wuyang20061105-oss/roboarm-_yang/Design_Notes.txt

RA-P300 精密机械臂概念迭代 | 2026-10-31 | 单位 mm
参考 RobotArm / BCN3D Moveo 模板拓扑重建；原 SLDASM 未直接导入。
4DOF + 平行夹爪，当前为静态装配；95 个原生三维实体，按部件分层。
中心距：上臂 125，前臂 100，腕心至指尖 75；名义中心线伸展 300。
底板 150x130x12；4x直径8.6通孔，直径14沉孔深6；中心走线孔直径22。
肩/肘/腕轴直径 16/14/12；上臂板厚8，前臂板厚7；夹爪开口32。
含减重窗、横撑、轴承座、法兰、内六角螺栓、散热环、夹垫及柔性线束。
电机、减速器、轴承及丝杆为外形示意；未建内部传动、装配运动约束。
未验证制造公差、负载刚度、驱动扭矩、重复定位精度及全行程干涉。
DWG 含 01_ISOMETRIC / 02_FRONT / 03_TOP / 04_SIDE 命名视图；审计错误0。
SAT 为实体交换文件；PNG 为 AutoCAD 原生导出预览。
