wuyang20061105-oss/roboarm-_yang/RA_P300_Preview.png

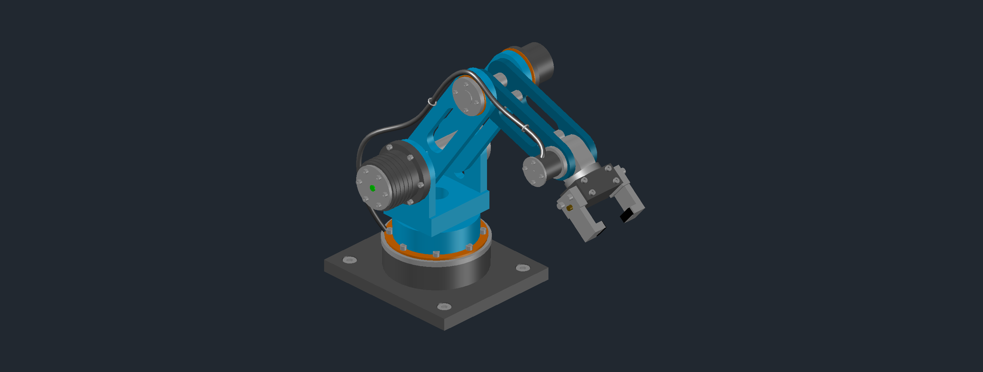
RA_P300_Preview.png
