wuyang20061105-oss/roboarm-_yang/CAD files/Driver.SLDASM

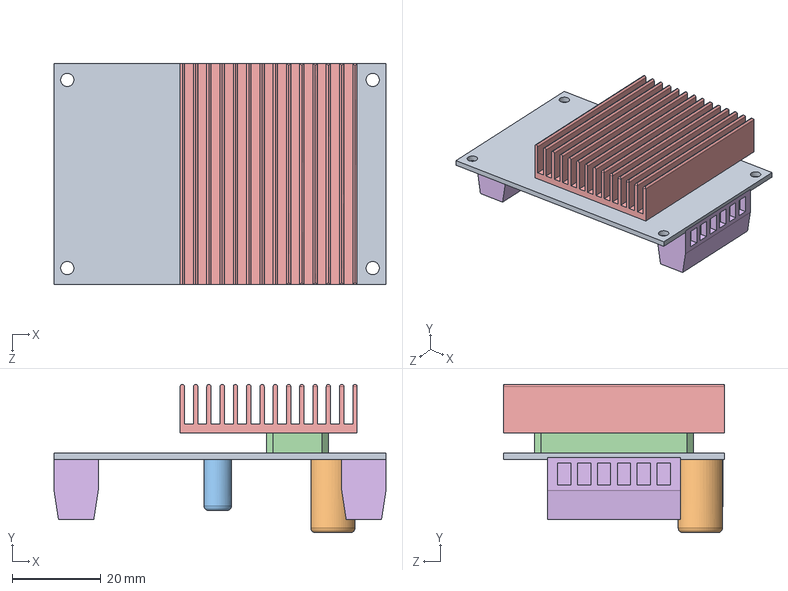
[picture p2: CAD file, 2026-10-31]
CAD files/Driver.SLDASM
75.0 x 33.5 x 50.0 mm
PCB TB6560
Capacitor 1
Capacitor 2
Chip
Sink
Terminal x 2
