wuyang20061105-oss/roboarm-_yang/CAD files/M1 Tensor D.SLDASM

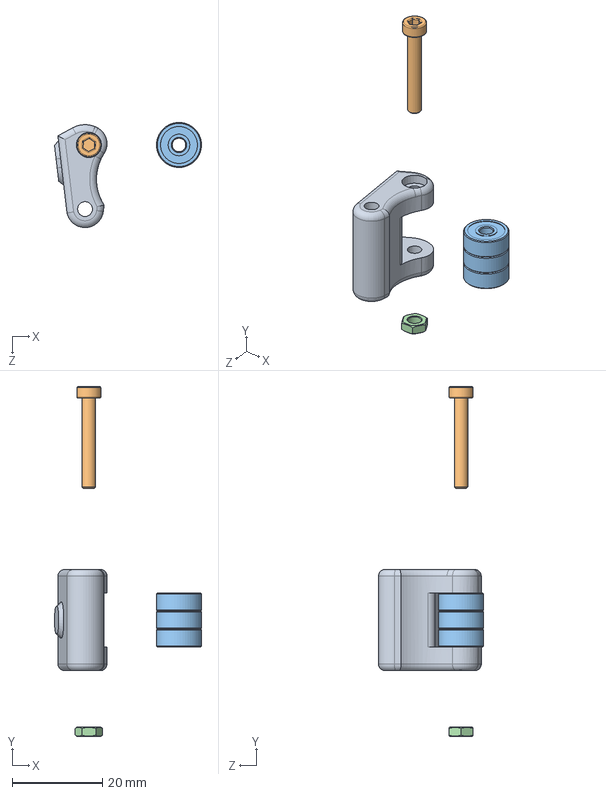
[picture p3: CAD file, 2026-10-31]
CAD files/M1 Tensor D.SLDASM
32.6 x 77.7 x 23.3 mm
T4M1E
M3x20
Bearing 3Bore 10Ext 4Height x 3
M3 Nut
