wuyang20061105-oss/roboarm-_yang/RobotArm.SLDASM

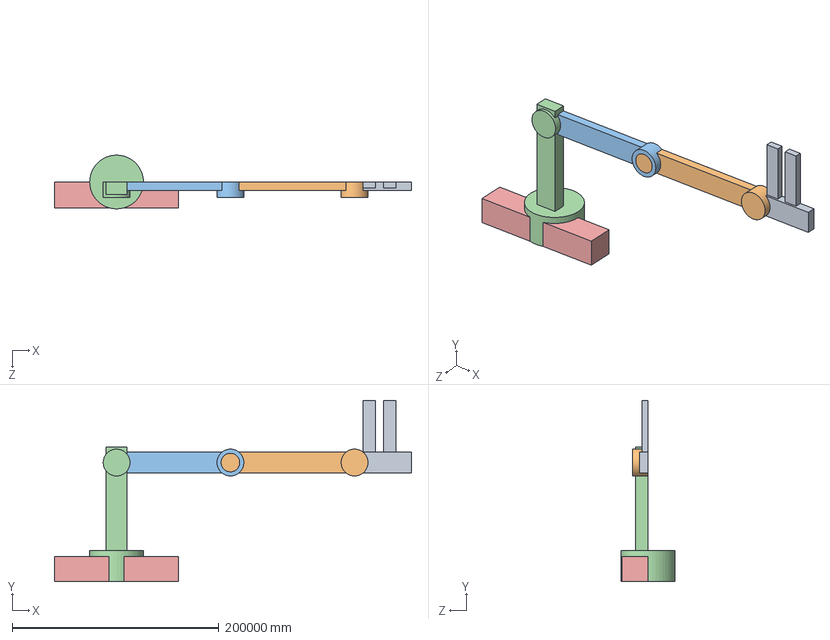
[picture p4: CAD file, 2026-10-31]
RobotArm.SLDASM
345000.0 x 175000.0 x 52000.0 mm
RobotArm_Base
RobotArm_Tower
RobotArm_UpperArm
RobotArm_Forearm
RobotArm_Hand
