wuyang20061105-oss/roboarm-_yang/CAD files/3M2.SLDASM

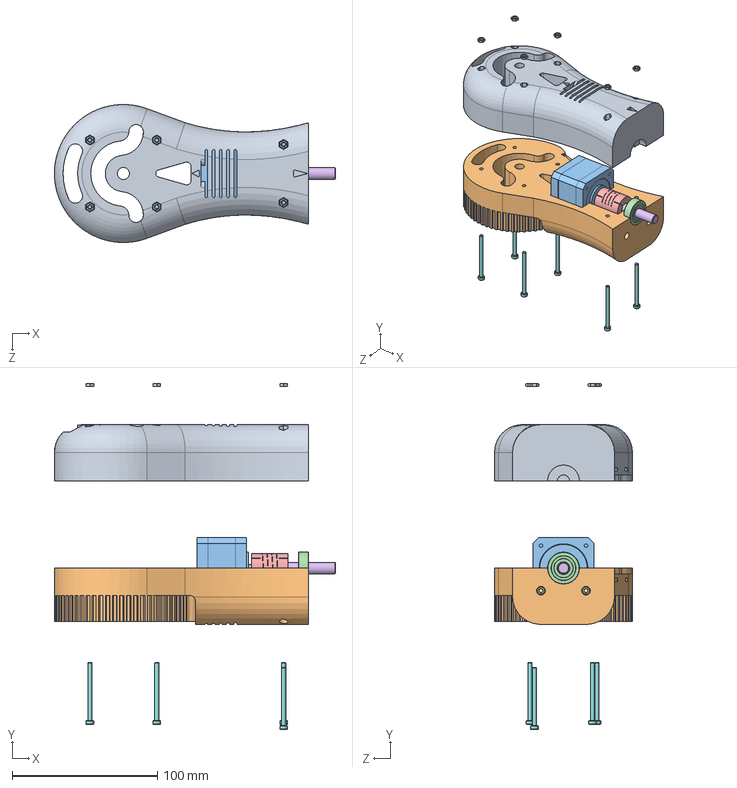
[picture p7: CAD file, 2026-10-31]
CAD files/3M2.SLDASM
193.6 x 238.2 x 95.0 mm
3M2C
3M2CC
Nema 17 Curt
8mm Bearing
Coupling 5 to 8 mm
Smooth bar 8mm x 50mm
M3x10 x 2
M3x40 x 6
M3 Nut x 6
