wuyang20061105-oss/roboarm-_yang/CAD files/BCN3D Moveo assembly.SLDASM

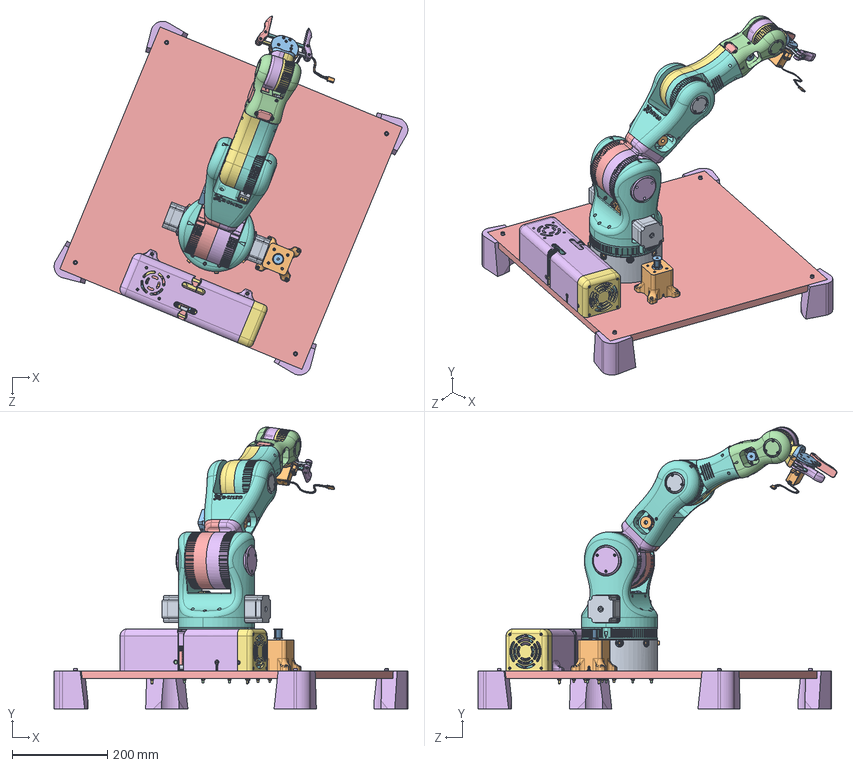
[picture p8: CAD file, 2026-10-31]
CAD files/BCN3D Moveo assembly.SLDASM
742.4 x 591.8 x 753.4 mm
1M2A
M5x20 x 8
Bearing 5mm x 8
Spacer M5x10 x 8
Spacer M8x20 x 2
8mm Bearing x 10
M5 Lock x 20
2M1D
Nema 23 x 2
M5x15 x 8
T2M1BI
M3 Nut x 27
M4 Nut x 7
M4x20 x 3
Bearing 4Bore 13Ext 5 x 9
T2M1BD
Arandela
Pulley 8mm IGNIS x 3
Smooth bar 8mm x 140mm
Brass insert M4 x 3
1M1B
M4x45 x 6
M4 Locknut x 20
M8x65
M8 Autoblocant x 2
2M2HA
2M2MA
M4x30 x 10
3M1D
T3M1C
M3x40 x 7
Nema 17 Reductor
M3x12 x 12
M4x16 x 4
Brass insert M3 x 14
Smooth bar 8mm x 121mm
3M2C
3M2CC
Nema 17 Curt
Coupling 5 to 8 mm
Smooth bar 8mm x 50mm
M3x10 x 16
4M1D
Nema 14
M3x8 x 5
T4M1E
M3x20
Bearing 3Bore 10Ext 4Height x 3
M3x35 x 5
Pulley M5 x 2
Tapa 4M1D x 2
TBC
4M2B
4M2CB
M3x25 x 3
Barra llisa 8mm x 80mm
Bottom Plate C
Top Plate C
Cilinder x 2
Gripper Left B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
