wuyang20061105-oss/roboarm-_yang/CAD files/2.SLDASM

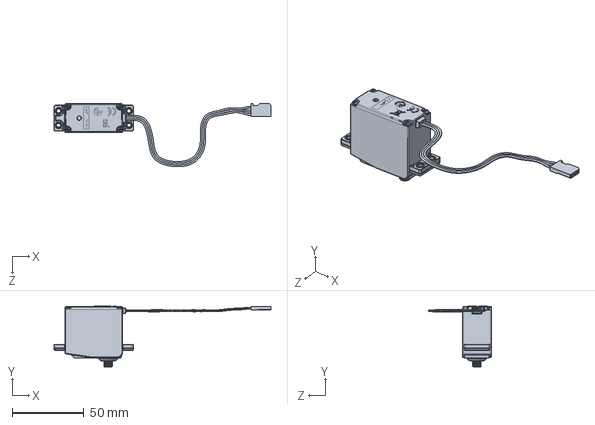
[picture p9: CAD file, 2026-10-31]
CAD files/2.SLDASM
151.2 x 42.3 x 44.1 mm
