wuyang20061105-oss/roboarm-_yang/CAD files/4M2.SLDASM

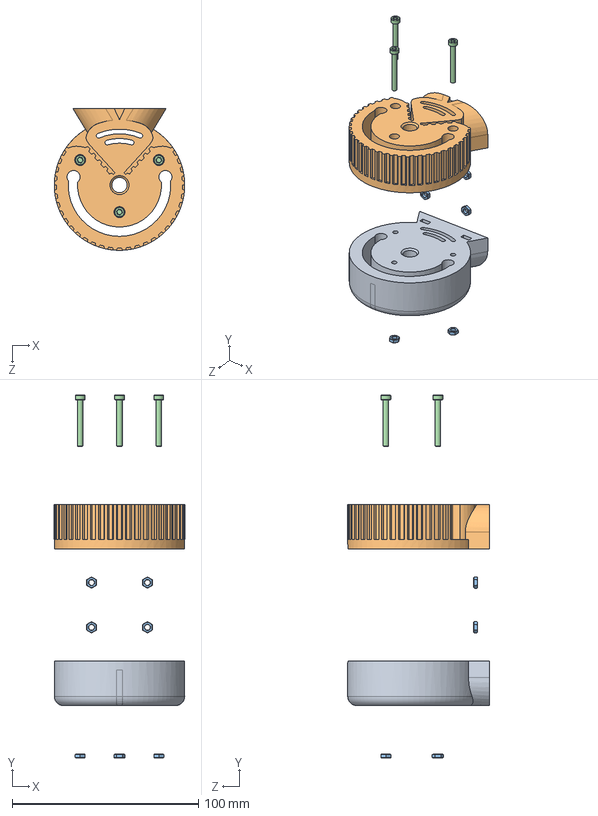
[picture p11: CAD file, 2026-10-31]
CAD files/4M2.SLDASM
70.0 x 194.7 x 76.0 mm
4M2B
4M2CB
M3 Nut x 7
M3x25 x 3
