wuyang20061105-oss/roboarm-_yang/CAD files/Drivers Support Assembly B.SLDASM

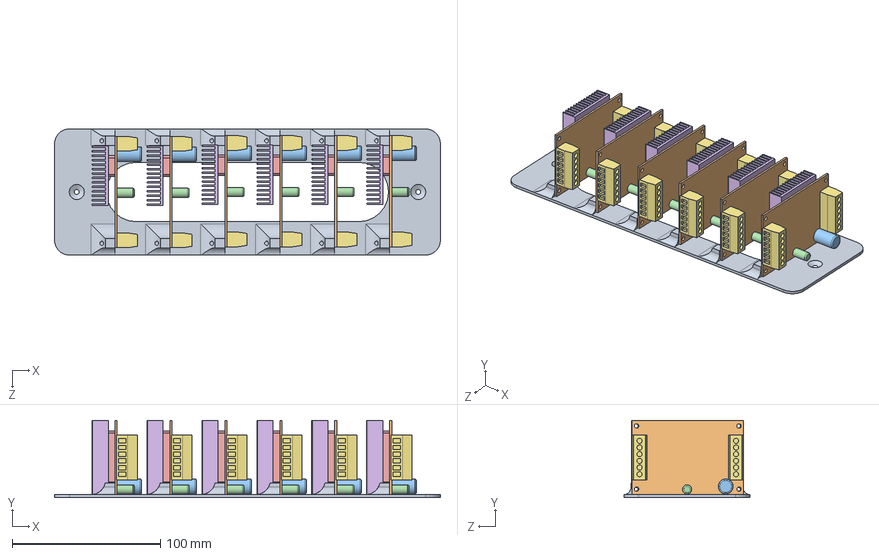
[picture p13: CAD file, 2026-10-31]
CAD files/Drivers Support Assembly B.SLDASM
260.0 x 52.0 x 85.0 mm
Suport Drivers E
PCB TB6560 x 6
Capacitor 1 x 6
Capacitor 2 x 6
Chip x 6
Sink x 6
Terminal x 12
