wuyang20061105-oss/roboarm-_yang/CAD files/Gripper B Assembly.SLDASM

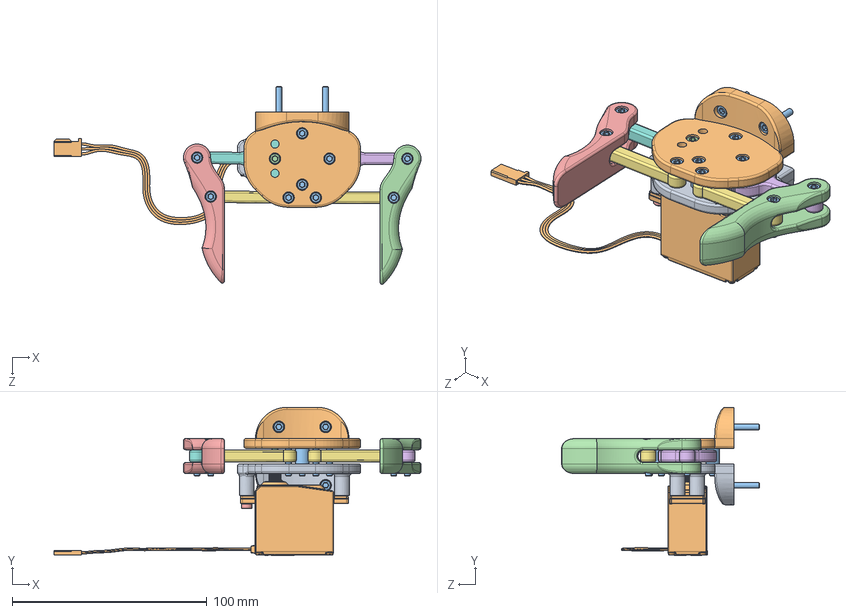
[picture p15: CAD file, 2026-10-31]
CAD files/Gripper B Assembly.SLDASM
188.5 x 76.1 x 101.5 mm
Bottom Plate C
Top Plate C
Cilinder x 2
Gripper Left B
Gripper Right B
Idol Gear B
Pivot Arm B x 2
Servo Gear B
M3 Nut x 9
Servo Futaba S3003
M3x16 x 13
M3x8
