wuyang20061105-oss/roboarm-_yang/CAD files/1M3.SLDASM

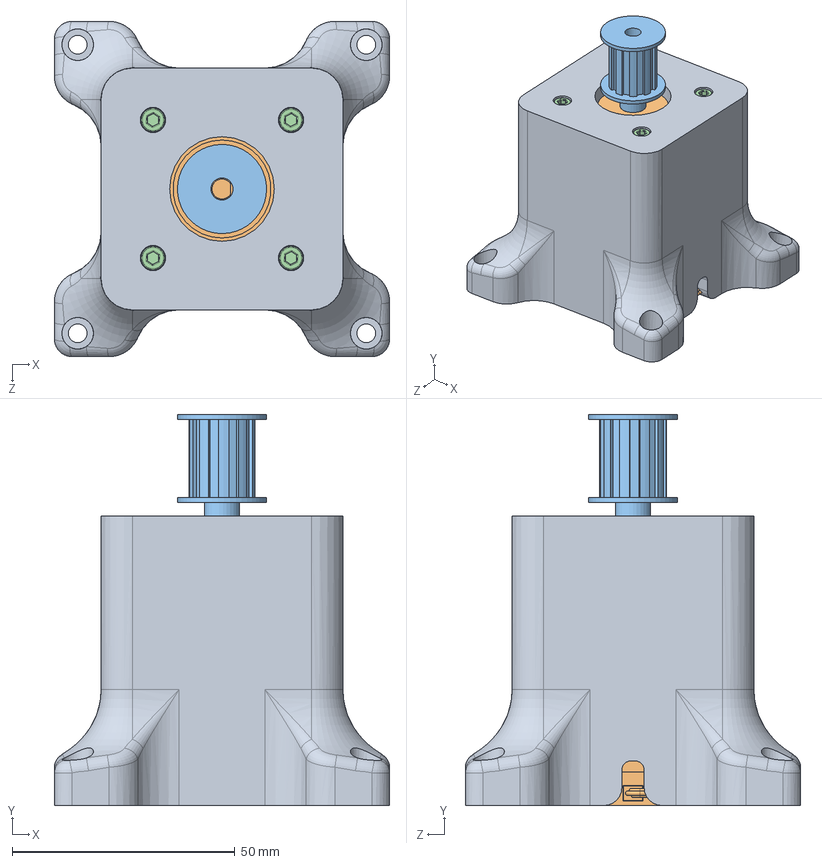
[picture p16: CAD file, 2026-10-31]
CAD files/1M3.SLDASM
75.3 x 87.8 x 75.3 mm
1M3A
Nema 17 Llarg
Pulley M5
M3x10 x 4
