wuyang20061105-oss/roboarm-_yang/CAD files/4M.SLDASM

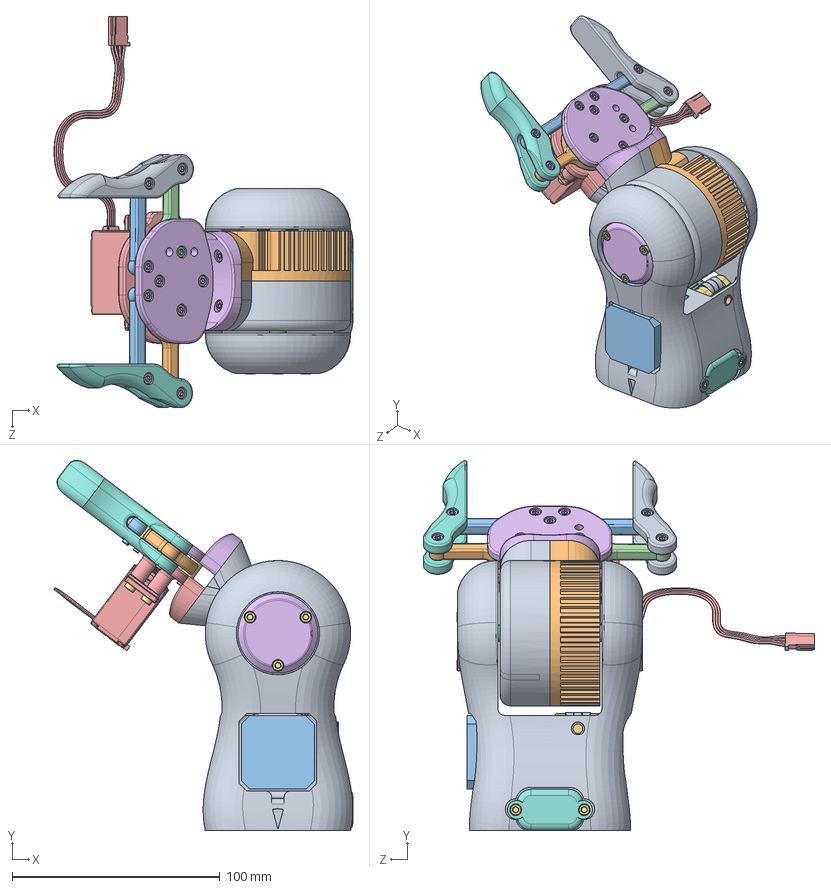
[picture p17: CAD file, 2026-10-31]
CAD files/4M.SLDASM
144.0 x 178.2 x 188.5 mm
4M1D
M3 Nut x 18
Nema 14
M3x8 x 5
8mm Bearing x 3
M8 Autoblocant
T4M1E
M3x20
Bearing 3Bore 10Ext 4Height x 3
M3x35
Pulley M5
Brass insert M3 x 8
Brass insert M4
Tapa 4M1D x 2
M3x12 x 8
TBC
4M2B
4M2CB
M3x25 x 3
Barra llisa 8mm x 80mm
Bottom Plate C
Top Plate C
Cilinder x 2
Gripper Left B
Gripper Right B
Idol Gear B
Pivot Arm B x 2
Servo Gear B
Servo Futaba S3003 x 2
M3x16 x 13
M3x10 x 4
