wuyang20061105-oss/roboarm-_yang/CAD files/2M2M assembly.SLDASM

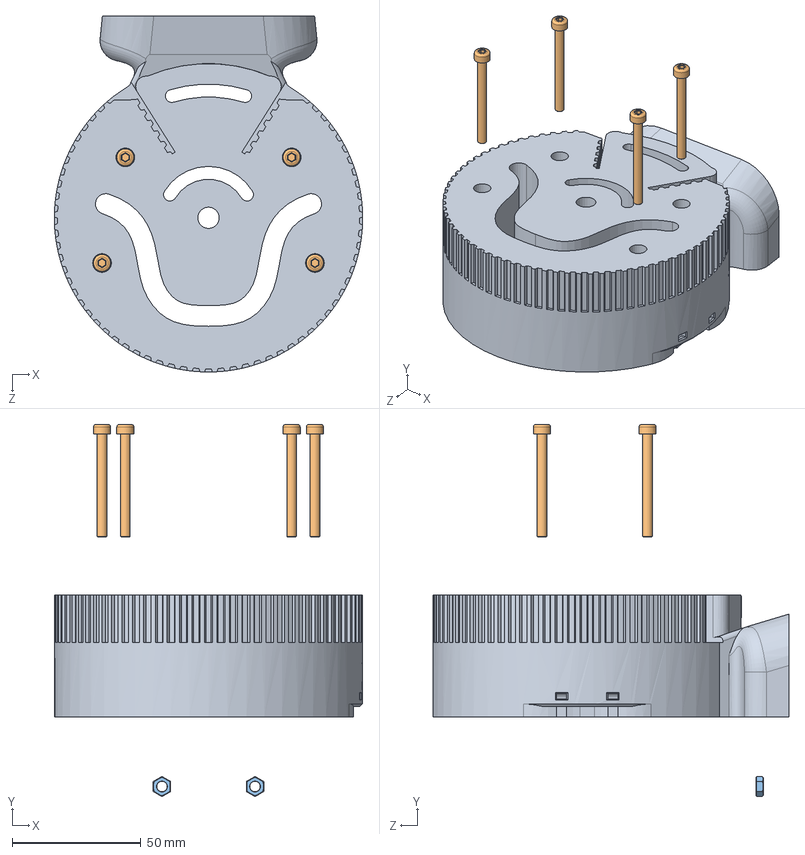
[picture p18: CAD file, 2026-10-31]
CAD files/2M2M assembly.SLDASM
120.0 x 144.8 x 138.5 mm
2M2MA
M4x40 x 4
M4 Nut x 2
