wuyang20061105-oss/roboarm-_yang/CAD files/1M2A.SLDPRT

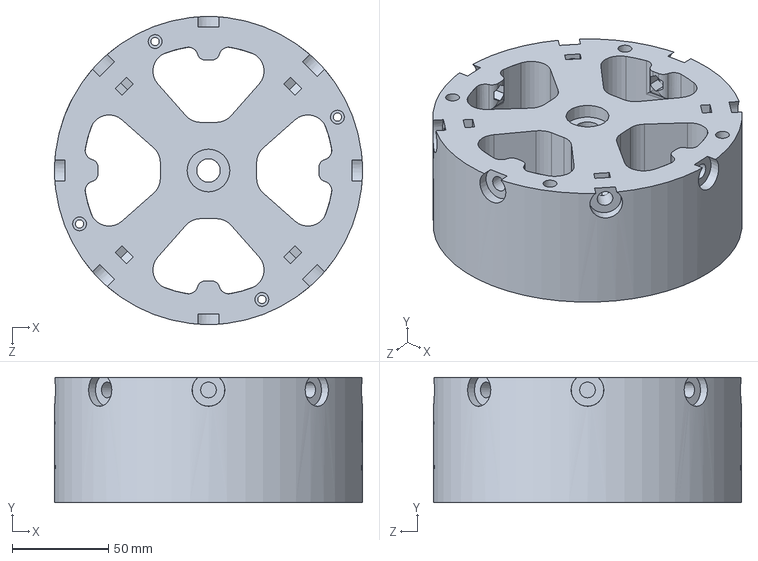
[picture p19: CAD file, 2026-10-31]
CAD files/1M2A.SLDPRT
160.0 x 65.0 x 160.0 mm
