wuyang20061105-oss/roboarm-_yang/RobotArm_Tower.SLDPRT

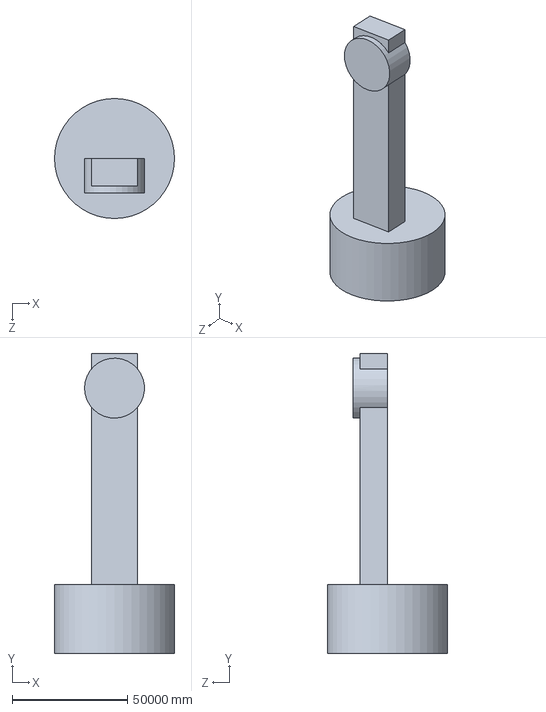
[picture p20: CAD file, 2026-10-31]
RobotArm_Tower.SLDPRT
52000.0 x 130000.0 x 52000.0 mm
