wuyang20061105-oss/roboarm-_yang/STL files/Articulation 1/1M1.STL

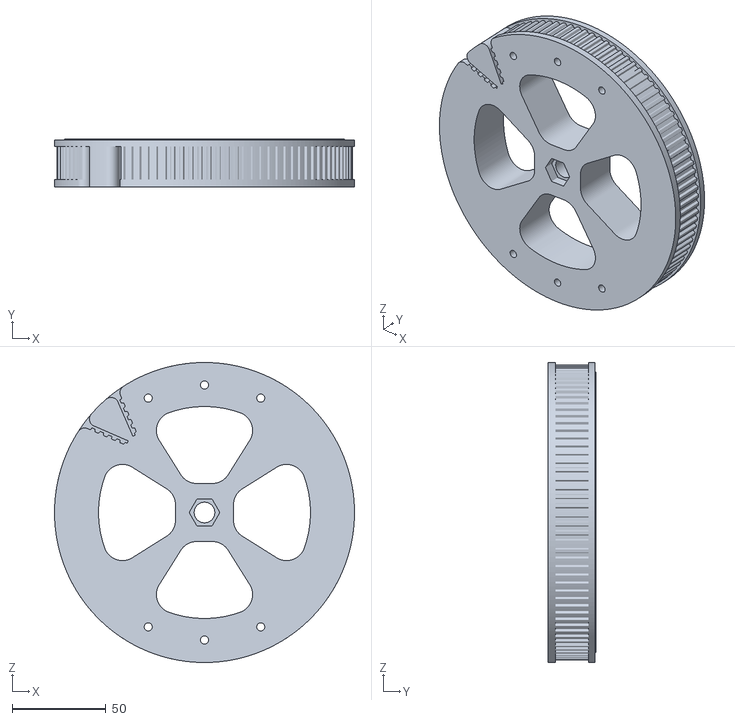
[picture p21: CAD file, 2026-10-31]
STL files/Articulation 1/1M1.STL
160.0 x 25.5 x 160.0
