wuyang20061105-oss/roboarm-_yang/STL files/Articulation 2/2M2M.STL

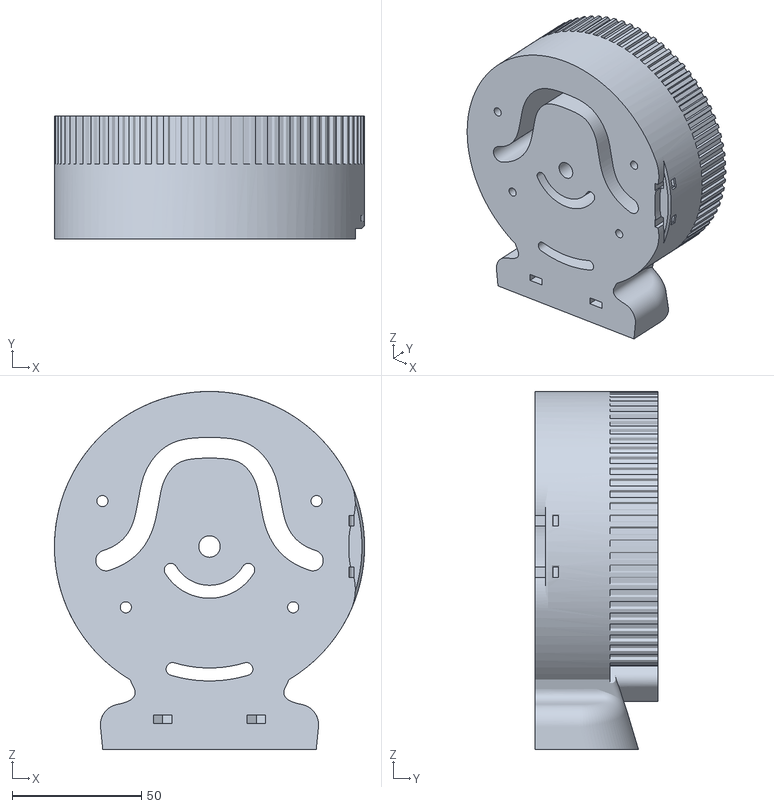
[picture p22: CAD file, 2026-10-31]
STL files/Articulation 2/2M2M.STL
120.0 x 47.5 x 138.5
