wuyang20061105-oss/roboarm-_yang/STL files/Articulation 3/T3M1C.stl

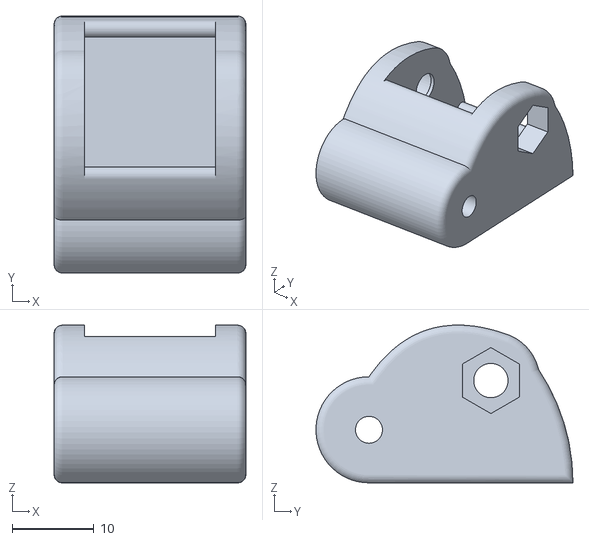
[picture p23: CAD file, 2026-10-31]
STL files/Articulation 3/T3M1C.stl
23.5 x 31.5 x 19.3
