wuyang20061105-oss/roboarm-_yang/STL files/Base/Potes.STL

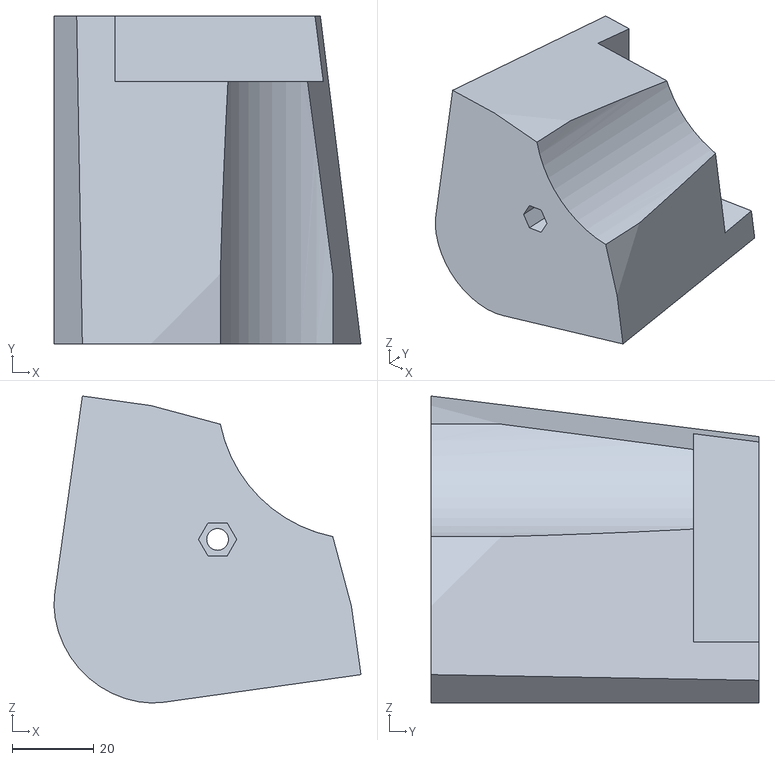
[picture p25: CAD file, 2026-10-31]
STL files/Base/Potes.STL
74.9 x 80.0 x 74.9
