wuyang20061105-oss/roboarm-_yang/STL files/Cover/Tapa 3M1.STL

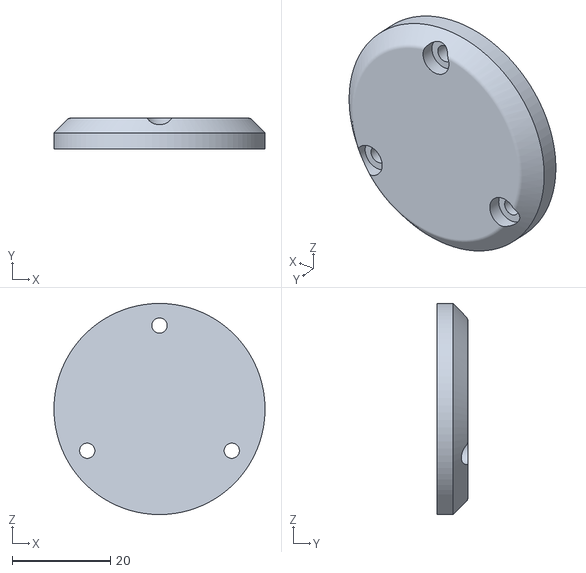
[picture p26: CAD file, 2026-10-31]
STL files/Cover/Tapa 3M1.STL
43.0 x 6.30 x 43.0
