wuyang20061105-oss/roboarm-_yang/STL files/Electronics box/Box.STL

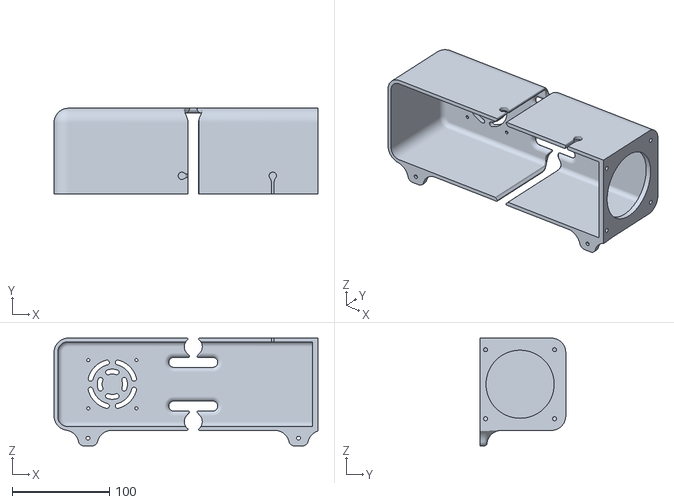
[picture p27: CAD file, 2026-10-31]
STL files/Electronics box/Box.STL
271.5 x 88.0 x 111.0
