wuyang20061105-oss/roboarm-_yang/STL files/Machine - tool/Top Plate.STL

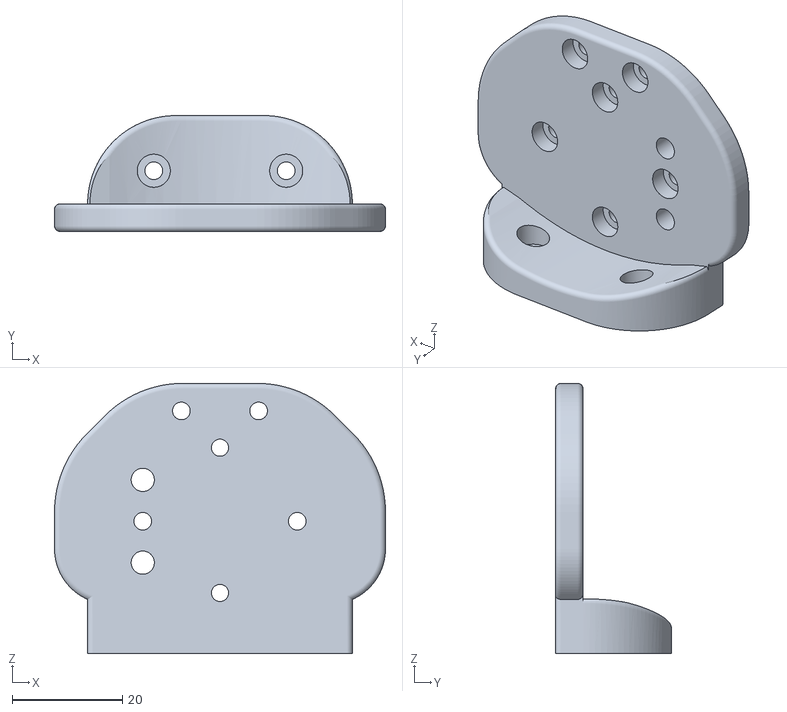
[picture p28: CAD file, 2026-10-31]
STL files/Machine - tool/Top Plate.STL
60.0 x 21.0 x 49.0
