wuyang20061105-oss/roboarm-_yang/CAD files/Bearing 5mm.SLDPRT

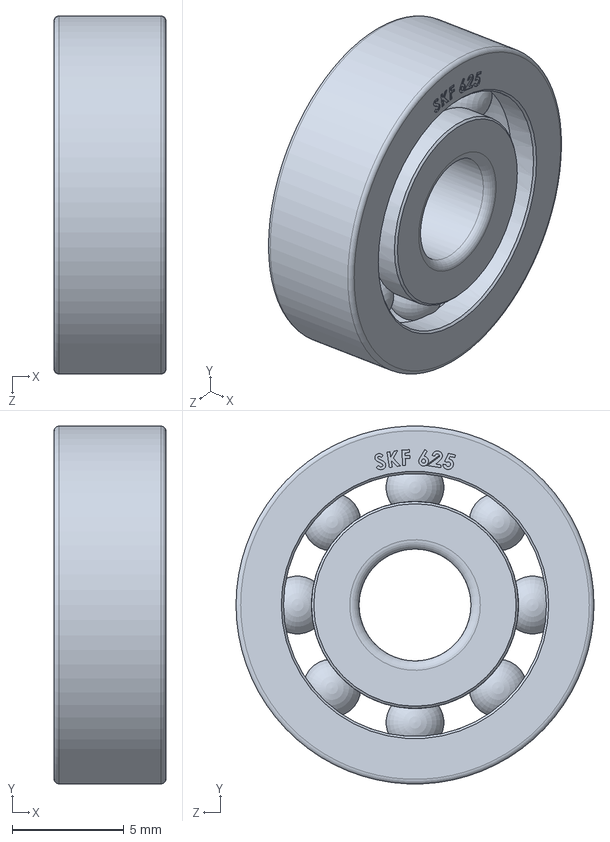
[picture p29: CAD file, 2026-10-31]
CAD files/Bearing 5mm.SLDPRT
5.00 x 16.0 x 16.0 mm
