wuyang20061105-oss/roboarm-_yang/RobotArm_Base.SLDPRT

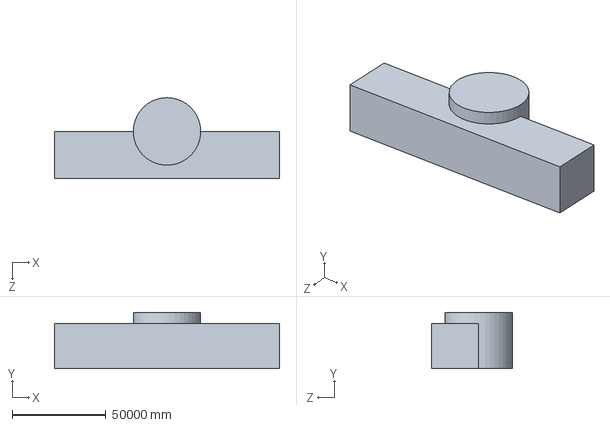
[picture p30: CAD file, 2026-10-31]
RobotArm_Base.SLDPRT
120000.0 x 30000.0 x 43000.0 mm
