wuyang20061105-oss/roboarm-_yang/STL files/Articulation 3/3M2C.STL

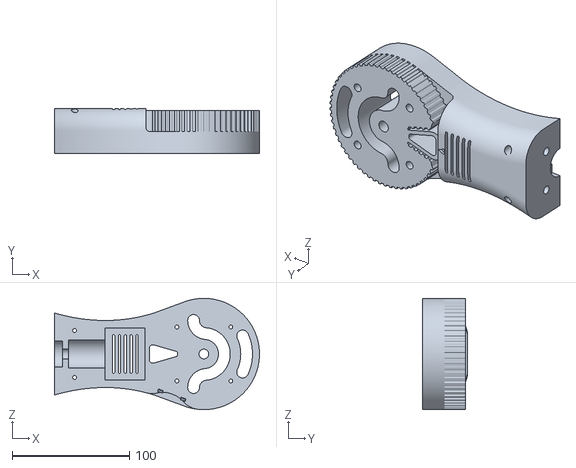
[picture p31: CAD file, 2026-10-31]
STL files/Articulation 3/3M2C.STL
175.0 x 38.8 x 95.0
