wuyang20061105-oss/roboarm-_yang/STL files/Articulation 4/4M1.STL

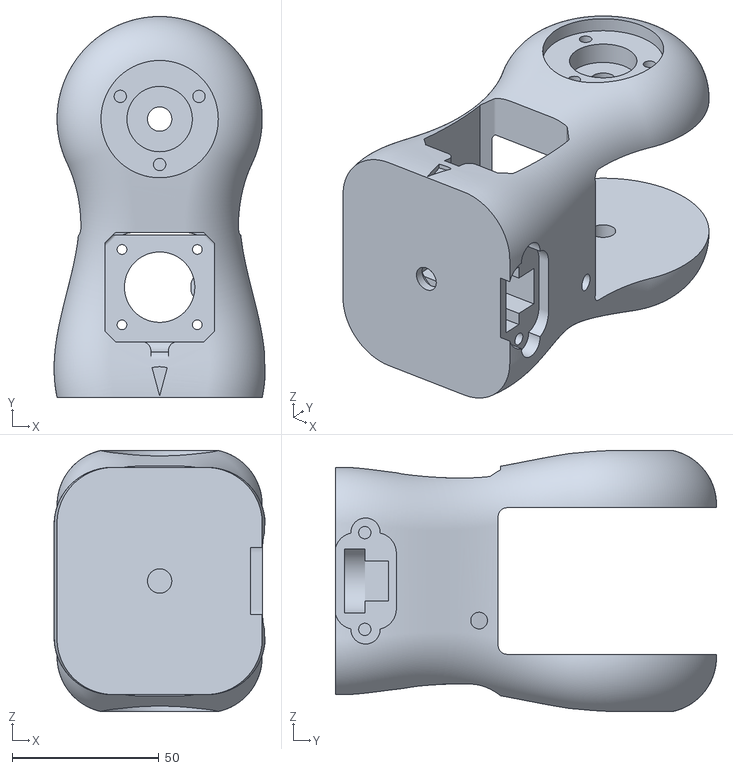
[picture p32: CAD file, 2026-10-31]
STL files/Articulation 4/4M1.STL
71.9 x 130.0 x 89.1
