wuyang20061105-oss/roboarm-_yang/STL files/Cover/Tapa 2M1.STL

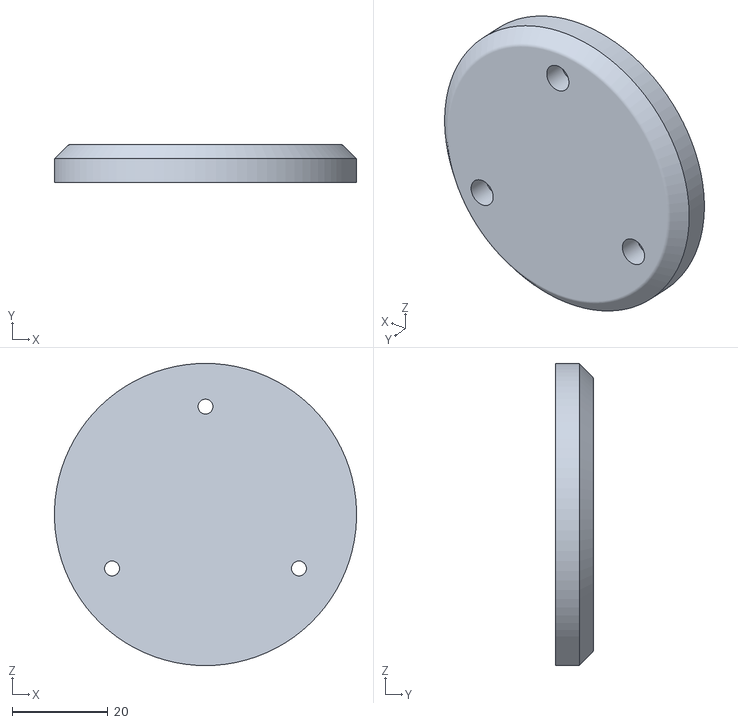
[picture p33: CAD file, 2026-10-31]
STL files/Cover/Tapa 2M1.STL
63.0 x 8.00 x 63.0
