wuyang20061105-oss/roboarm-_yang/STL files/Electronics box/Fan Module.STL

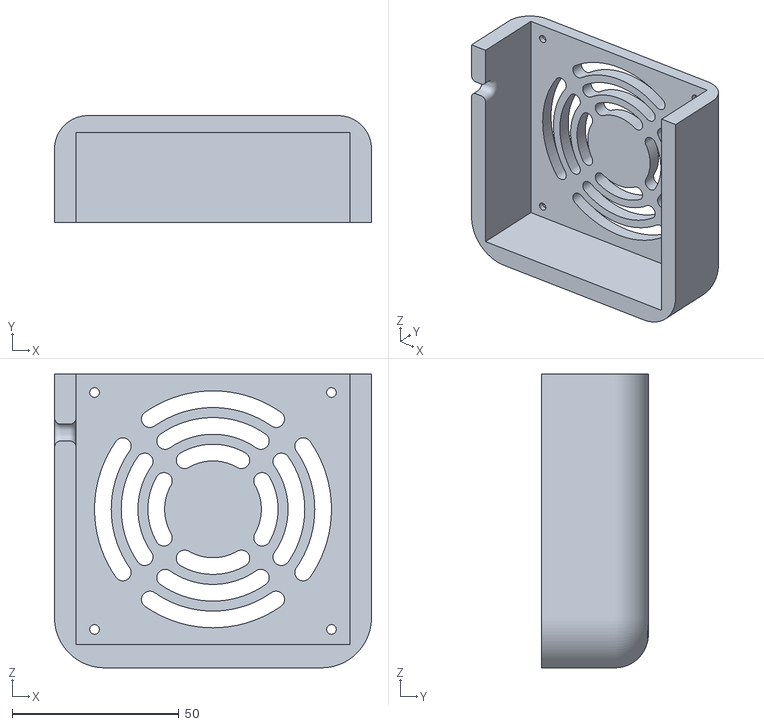
[picture p34: CAD file, 2026-10-31]
STL files/Electronics box/Fan Module.STL
95.0 x 32.0 x 88.0
