wuyang20061105-oss/roboarm-_yang/STL files/Machine - tool/Gripper Left.STL

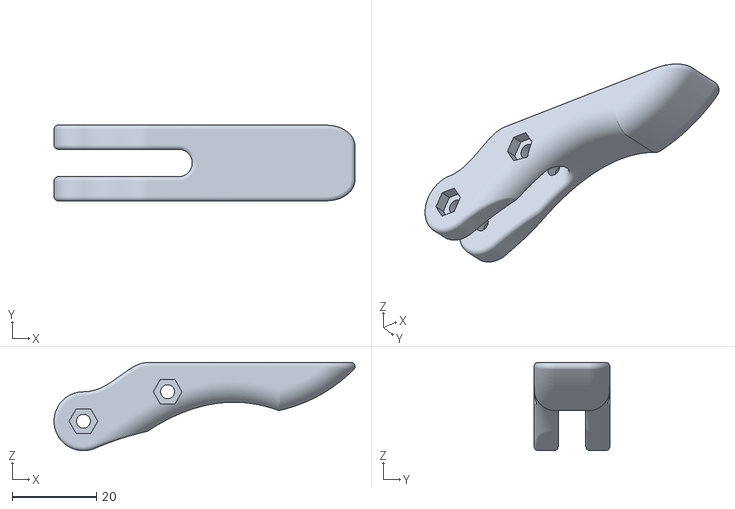
[picture p35: CAD file, 2026-10-31]
STL files/Machine - tool/Gripper Left.STL
71.5 x 18.0 x 21.0
