wuyang20061105-oss/roboarm-_yang/CAD files/Arandela.SLDPRT

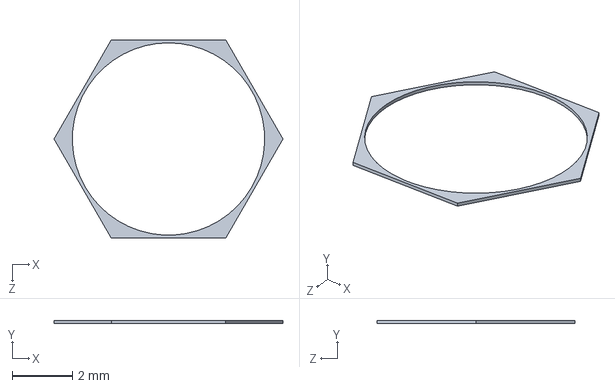
[picture p36: CAD file, 2026-10-31]
CAD files/Arandela.SLDPRT
7.62 x 0.1 x 6.60 mm
