wuyang20061105-oss/roboarm-_yang/RobotArm_Hand.SLDPRT

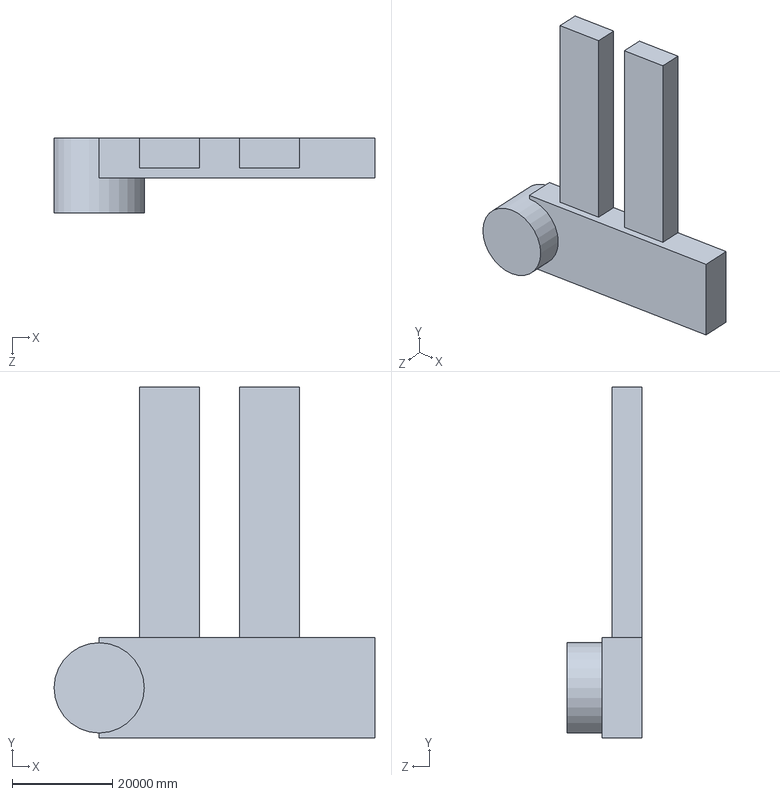
[picture p37: CAD file, 2026-10-31]
RobotArm_Hand.SLDPRT
64000.0 x 70000.0 x 15000.0 mm
