wuyang20061105-oss/roboarm-_yang/STL files/Articulation 1/1M3.STL

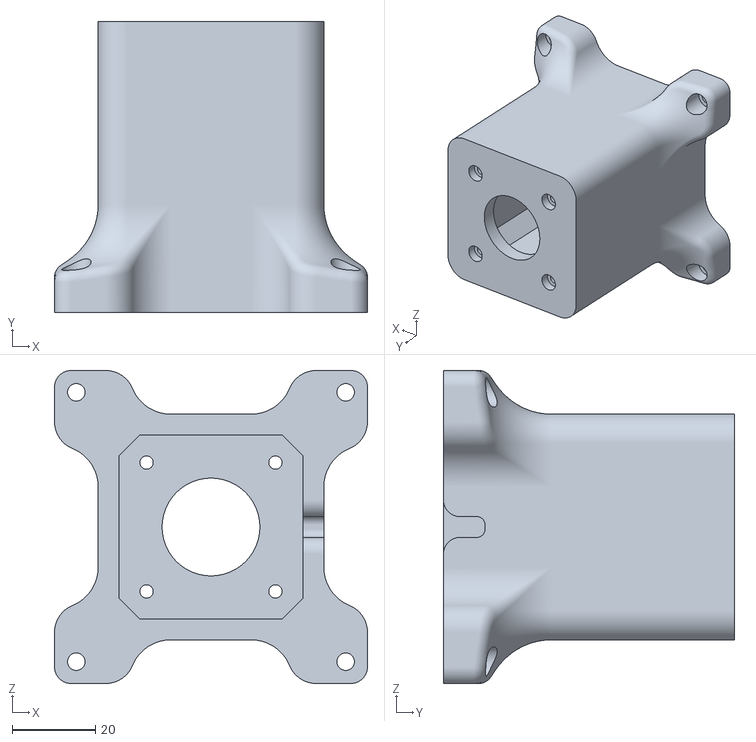
[picture p38: CAD file, 2026-10-31]
STL files/Articulation 1/1M3.STL
75.3 x 70.0 x 75.3
