wuyang20061105-oss/roboarm-_yang/STL files/Articulation 2/T2M1BI.stl

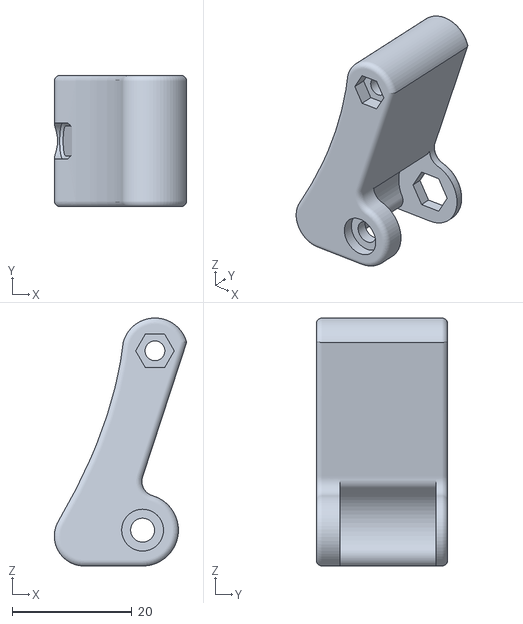
[picture p39: CAD file, 2026-10-31]
STL files/Articulation 2/T2M1BI.stl
22.2 x 22.0 x 41.5
