wuyang20061105-oss/roboarm-_yang/STL files/Articulation 3/3M2.STL

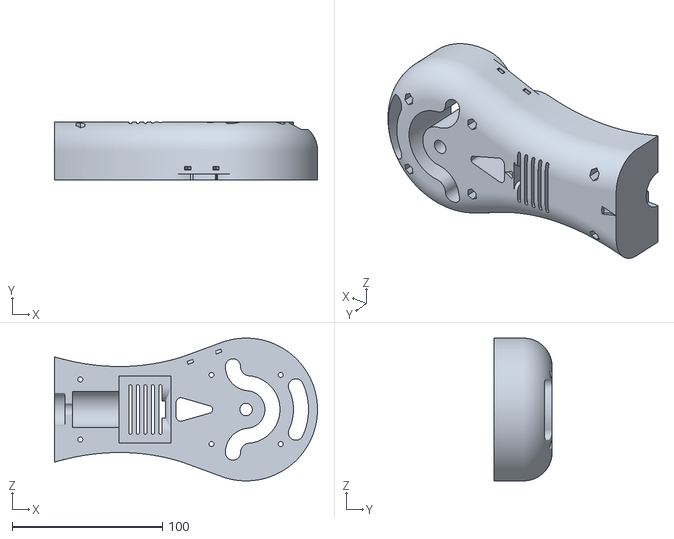
[picture p40: CAD file, 2026-10-31]
STL files/Articulation 3/3M2.STL
175.0 x 38.8 x 95.0
