wuyang20061105-oss/roboarm-_yang/STL files/Articulation 4/T4M1E.stl

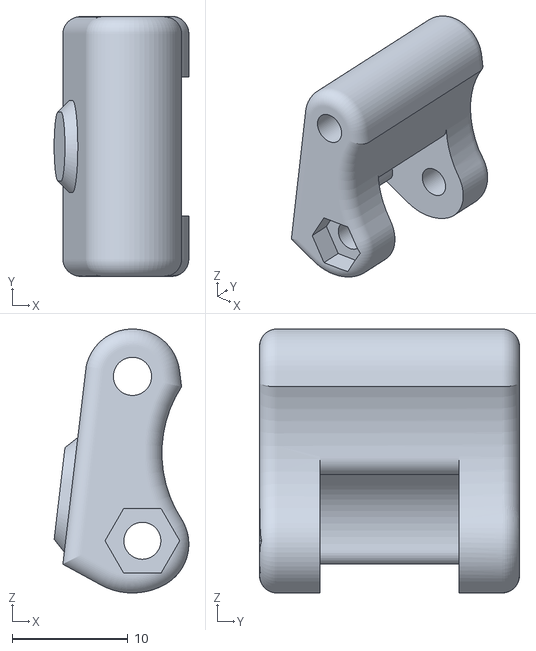
[picture p41: CAD file, 2026-10-31]
STL files/Articulation 4/T4M1E.stl
11.7 x 22.5 x 22.9
