wuyang20061105-oss/roboarm-_yang/STL files/Cover/Tapa TBB.STL

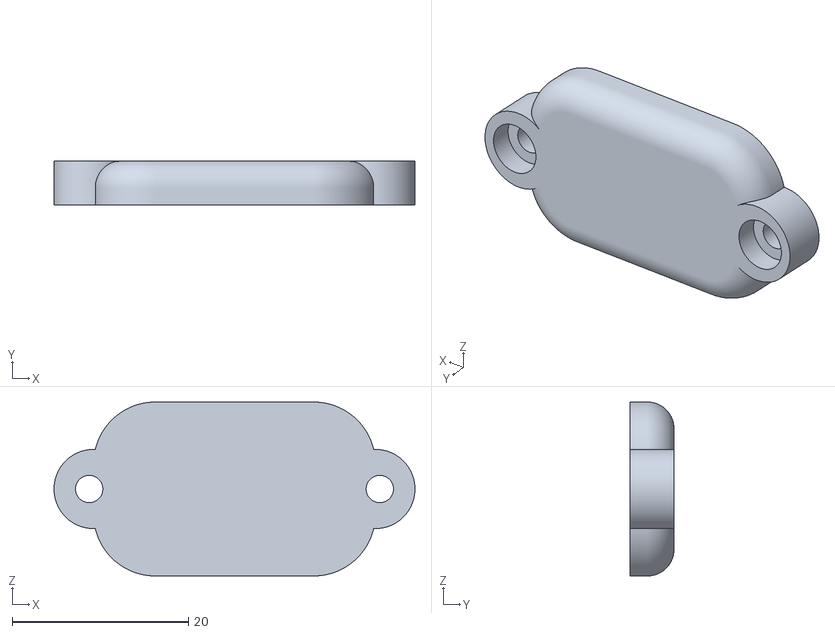
[picture p42: CAD file, 2026-10-31]
STL files/Cover/Tapa TBB.STL
41.0 x 5.00 x 19.8
