wuyang20061105-oss/roboarm-_yang/STL files/Electronics box/Suport Drivers.STL

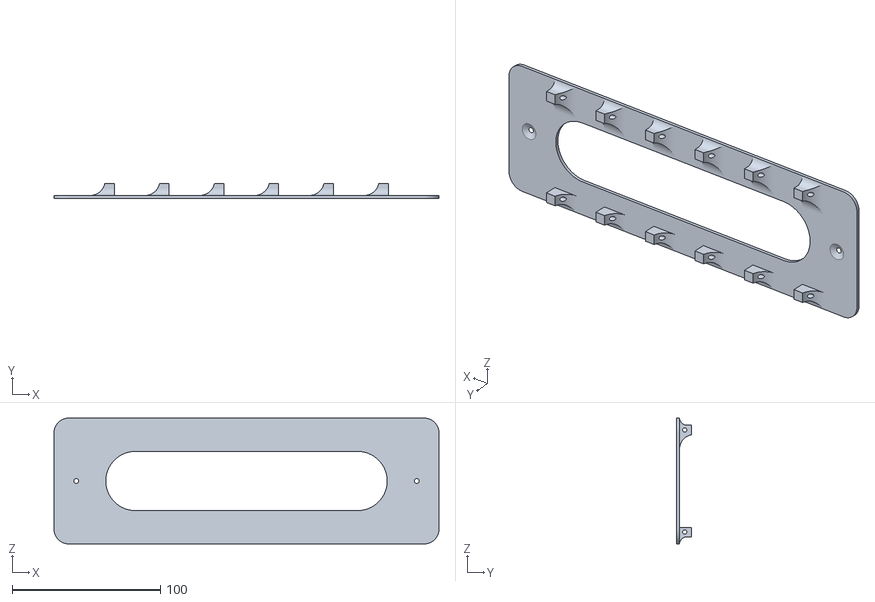
[picture p43: CAD file, 2026-10-31]
STL files/Electronics box/Suport Drivers.STL
260.0 x 10.0 x 85.0
