wuyang20061105-oss/roboarm-_yang/RobotArm_UpperArm.SLDPRT

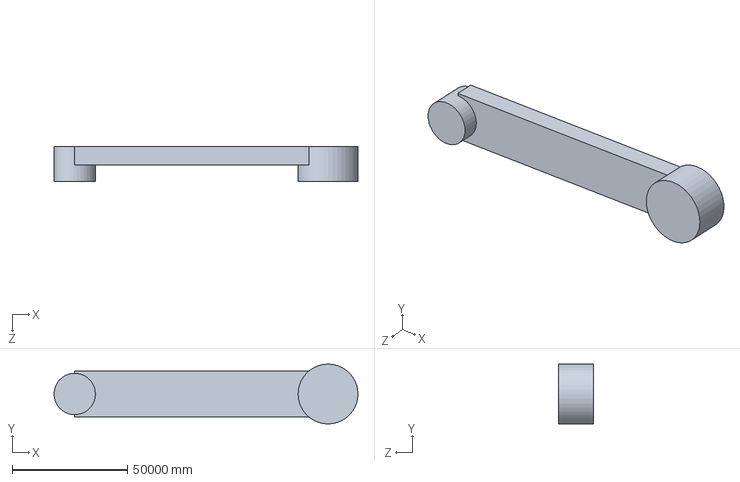
[picture p44: CAD file, 2026-10-31]
RobotArm_UpperArm.SLDPRT
132000.0 x 26000.0 x 15000.0 mm
