wuyang20061105-oss/roboarm-_yang/STL files/Articulation 2/T2M1BD.stl

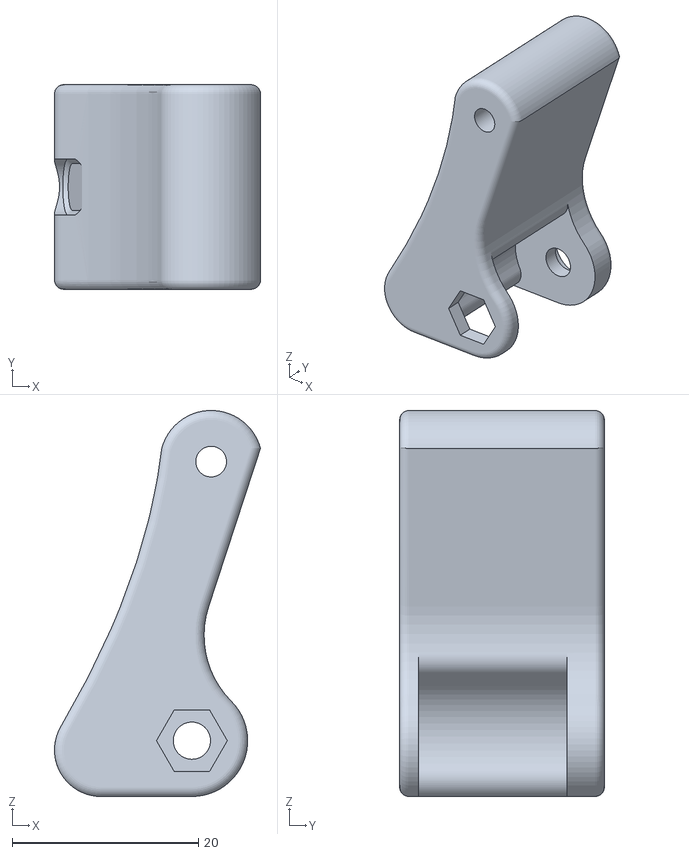
[picture p45: CAD file, 2026-10-31]
STL files/Articulation 2/T2M1BD.stl
22.2 x 22.0 x 41.5
