wuyang20061105-oss/roboarm-_yang/STL files/Articulation 3/3M1.STL

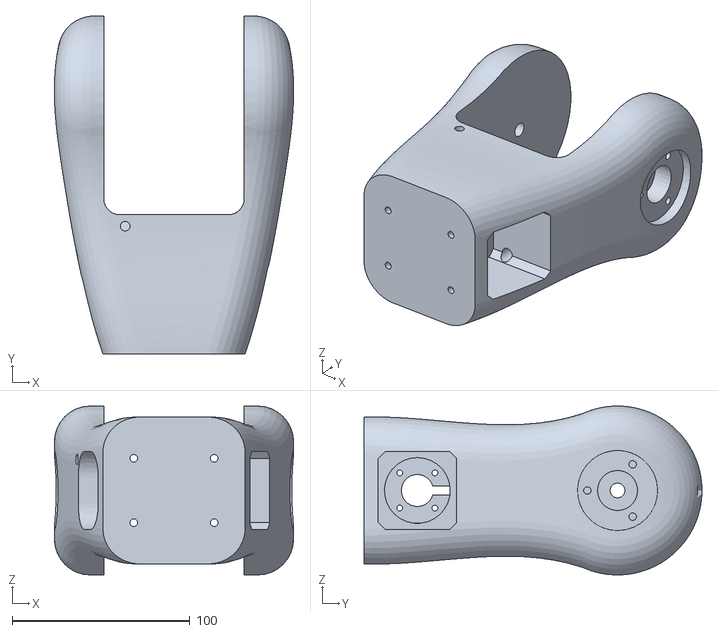
[picture p46: CAD file, 2026-10-31]
STL files/Articulation 3/3M1.STL
134.6 x 190.1 x 95.0
