wuyang20061105-oss/roboarm-_yang/STL files/Articulation 4/4M2.STL

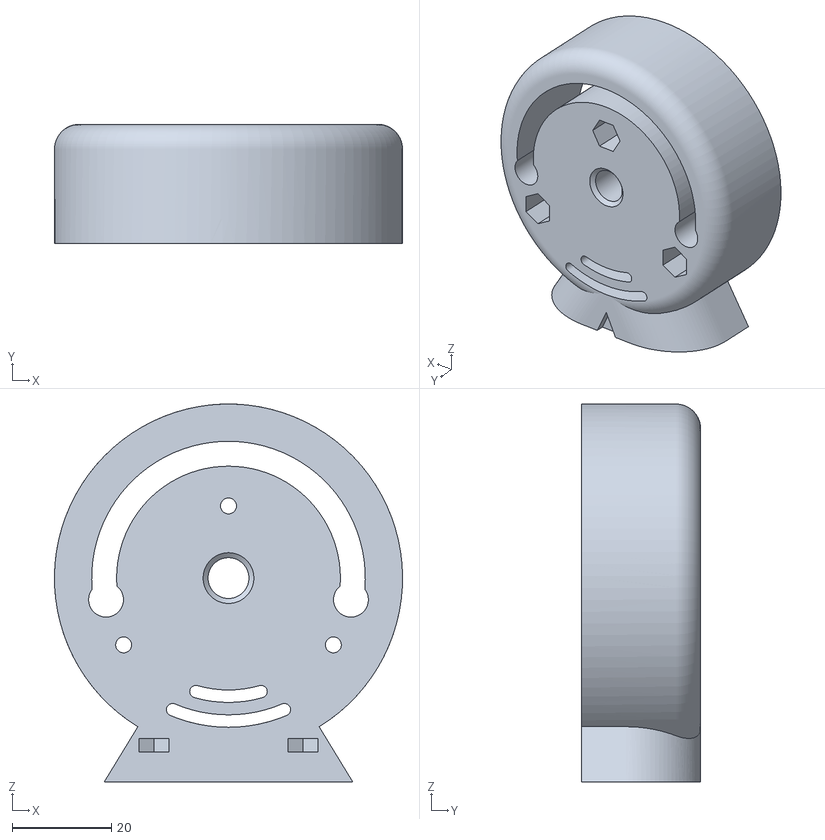
[picture p47: CAD file, 2026-10-31]
STL files/Articulation 4/4M2.STL
70.0 x 24.0 x 76.0
