wuyang20061105-oss/roboarm-_yang/STL files/Cover/Tapa 4M1.STL

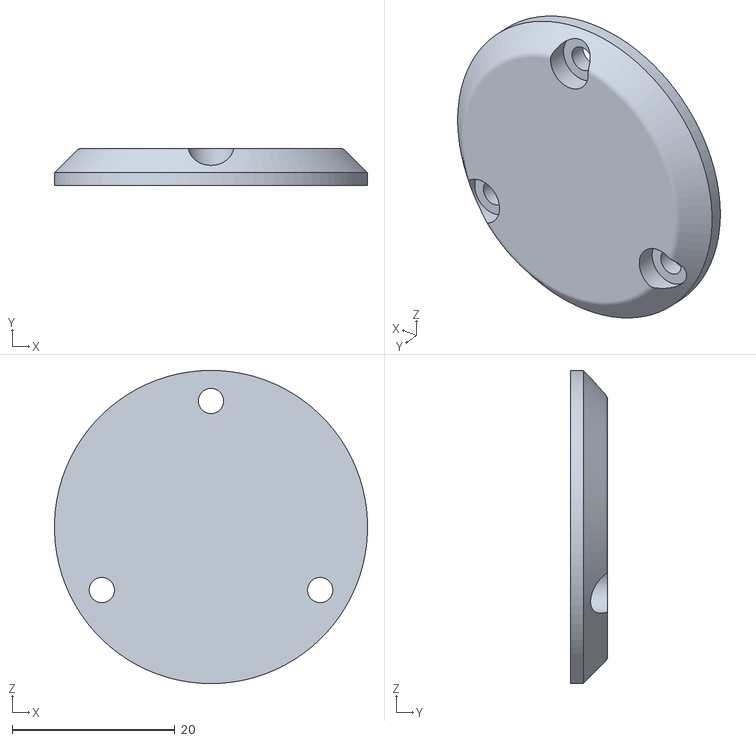
[picture p48: CAD file, 2026-10-31]
STL files/Cover/Tapa 4M1.STL
38.5 x 4.60 x 38.5
