wuyang20061105-oss/roboarm-_yang/STL files/Machine - tool/Bottom Plate.STL

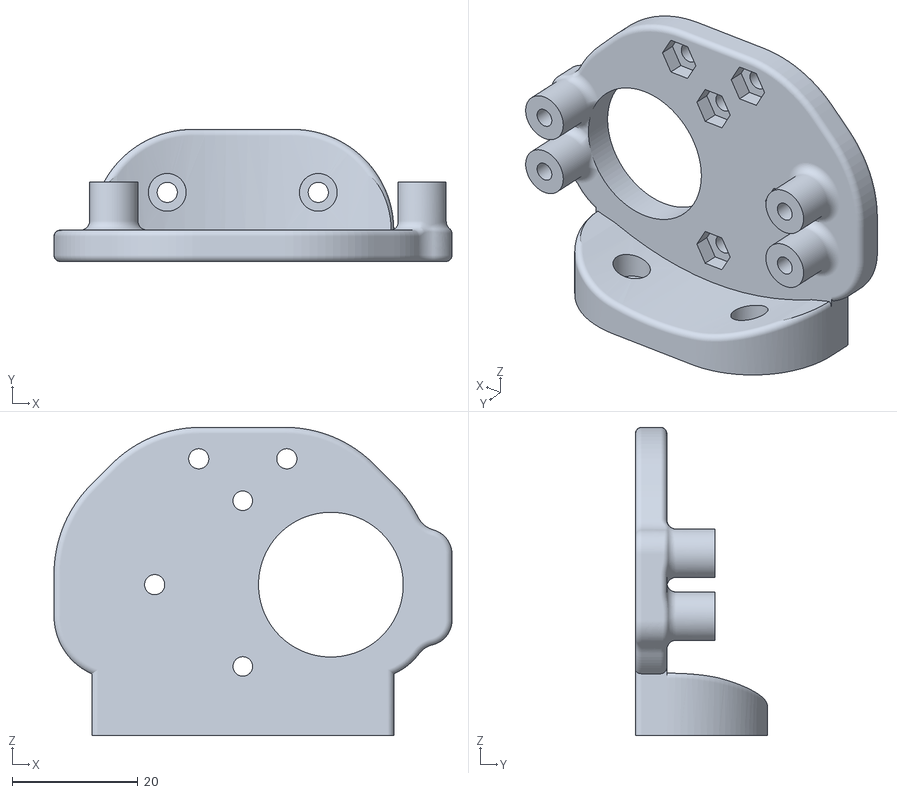
[picture p49: CAD file, 2026-10-31]
STL files/Machine - tool/Bottom Plate.STL
63.2 x 21.0 x 49.0
