wuyang20061105-oss/roboarm-_yang/RobotArm_Forearm.SLDPRT

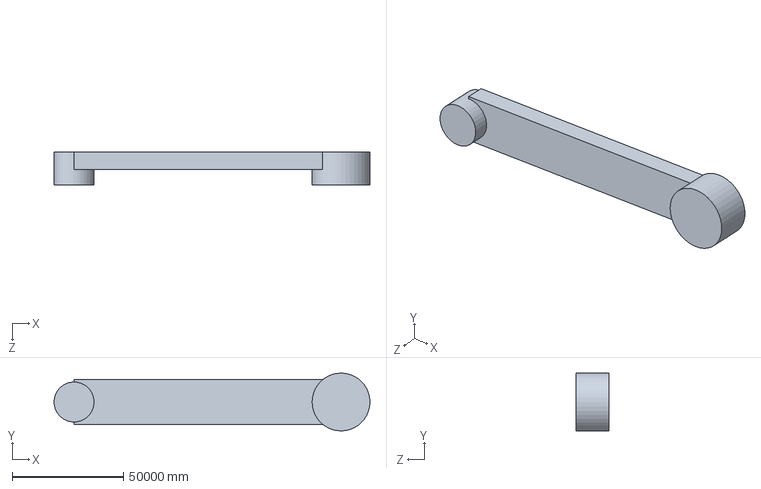
[picture p50: CAD file, 2026-10-31]
RobotArm_Forearm.SLDPRT
142000.0 x 26000.0 x 15000.0 mm
