wuyang20061105-oss/roboarm-_yang/STL files/Articulation 2/2M1.STL

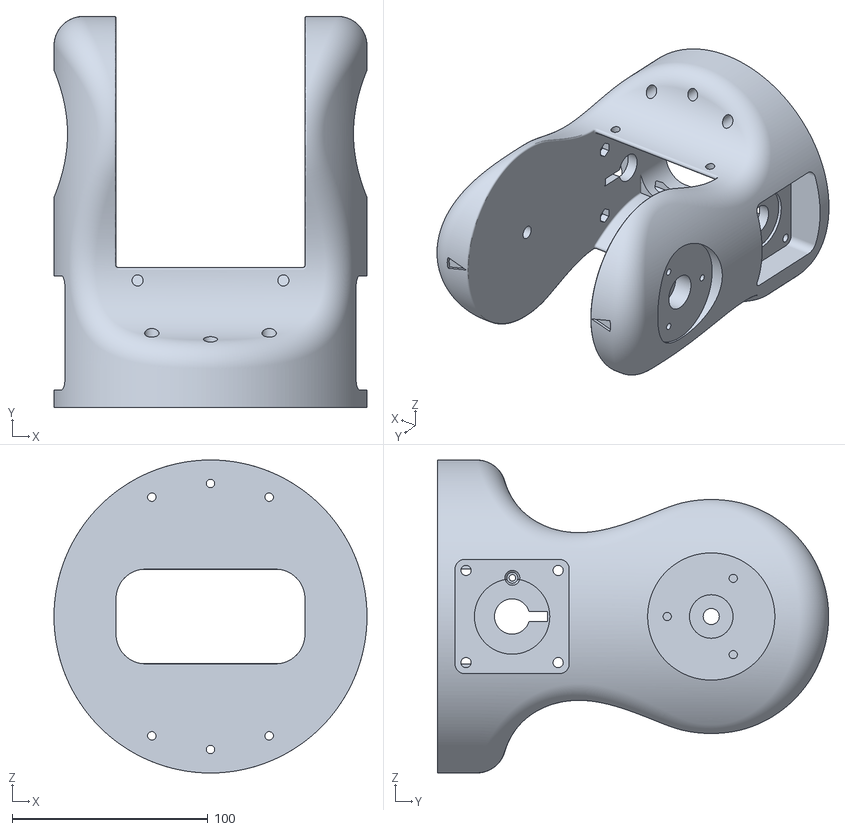
[picture p51: CAD file, 2026-10-31]
STL files/Articulation 2/2M1.STL
160.0 x 200.0 x 160.0
