wuyang20061105-oss/roboarm-_yang/STL files/Machine - tool/Pivot Arm.STL

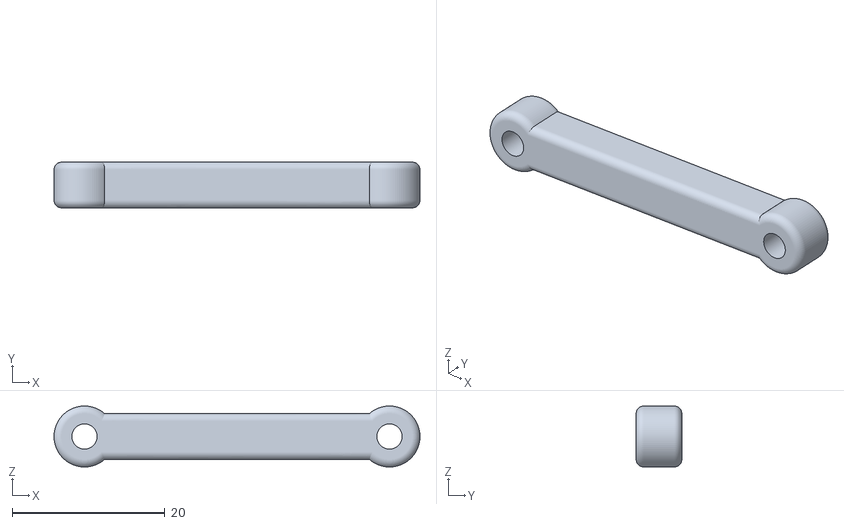
[picture p52: CAD file, 2026-10-31]
STL files/Machine - tool/Pivot Arm.STL
48.0 x 6.00 x 8.00
