wuyang20061105-oss/roboarm-_yang/STL files/Machine - tool/Servo Gear.STL

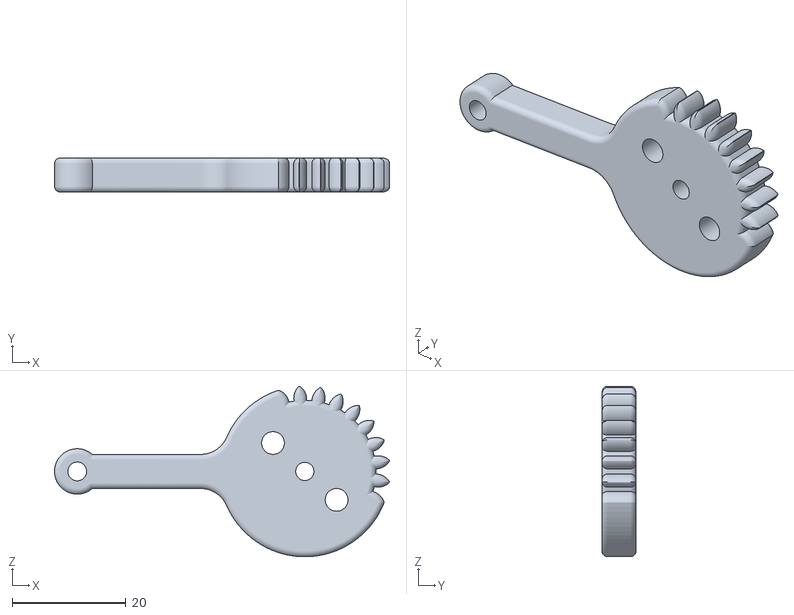
[picture p53: CAD file, 2026-10-31]
STL files/Machine - tool/Servo Gear.STL
58.9 x 6.00 x 30.0
