wuyang20061105-oss/roboarm-_yang/CAD files/8mm Bearing.SLDPRT

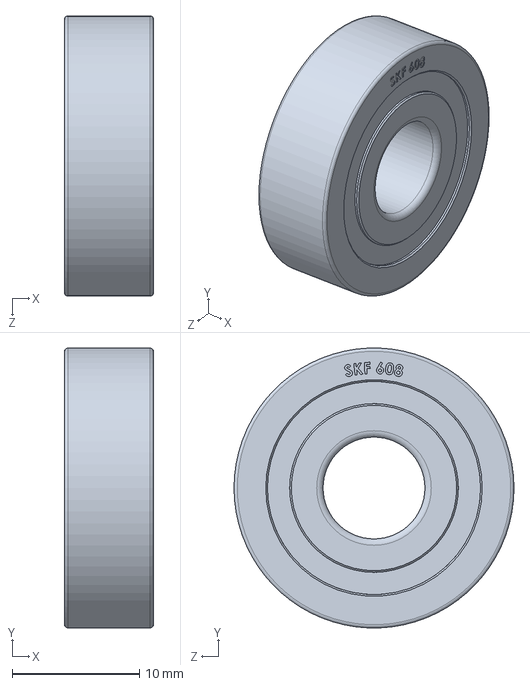
[picture p54: CAD file, 2026-10-31]
CAD files/8mm Bearing.SLDPRT
7.00 x 22.0 x 22.0 mm
