wuyang20061105-oss/roboarm-_yang/STL files/Machine - tool/Cilinder.STL

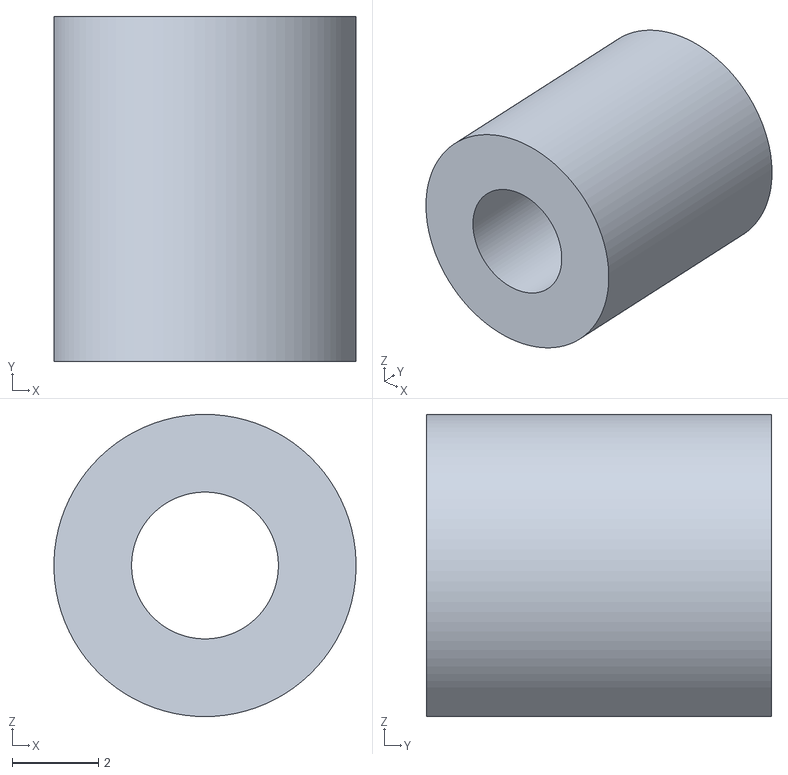
[picture p55: CAD file, 2026-10-31]
STL files/Machine - tool/Cilinder.STL
7.00 x 8.00 x 7.00
