wuyang20061105-oss/roboarm-_yang/CAD files/Fan.SLDPRT

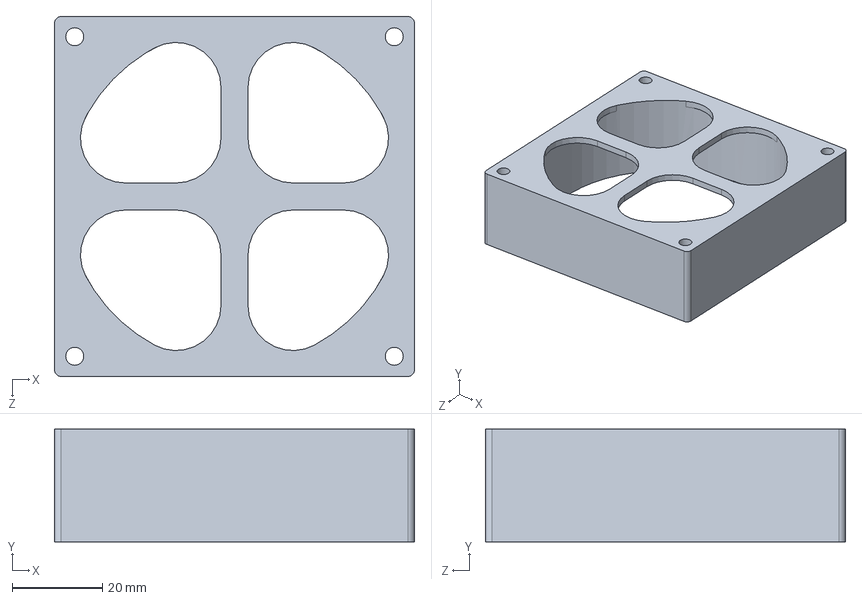
[picture p56: CAD file, 2026-10-31]
CAD files/Fan.SLDPRT
80.0 x 25.0 x 80.0 mm
