wuyang20061105-oss/roboarm-_yang/STL files/Machine - tool/Idol Gear.STL

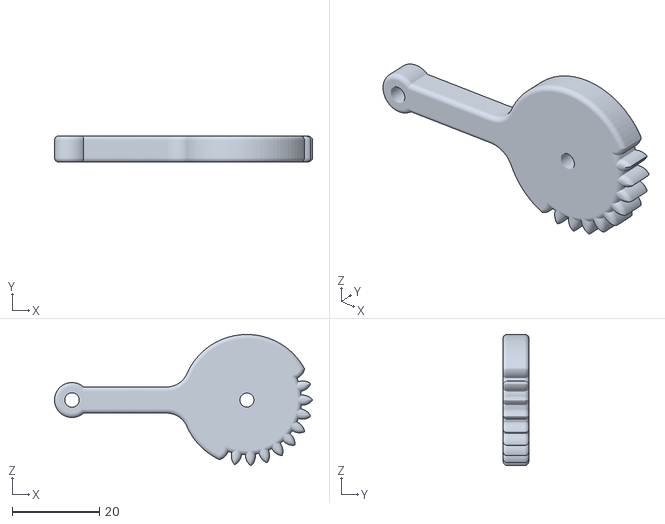
[picture p57: CAD file, 2026-10-31]
STL files/Machine - tool/Idol Gear.STL
59.0 x 6.00 x 30.0
