wuyang20061105-oss/roboarm-_yang/CAD files/Bearing 4Bore 13Ext 5.SLDPRT

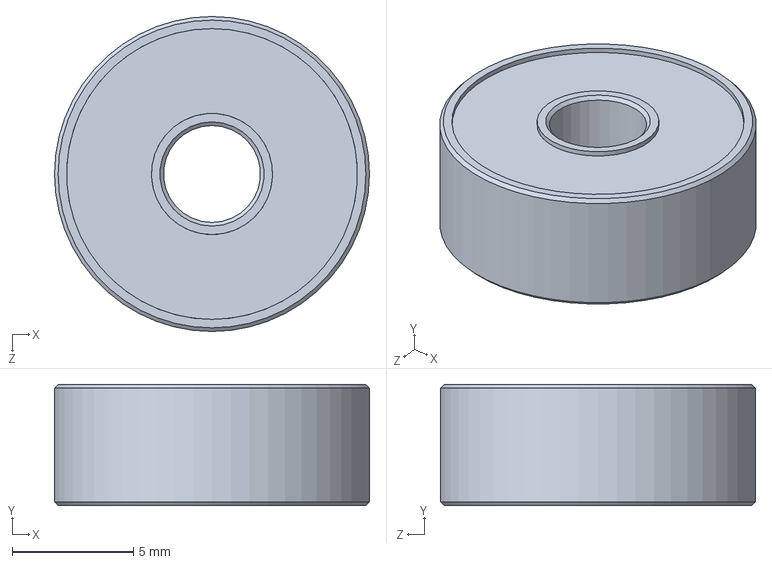
[picture p58: CAD file, 2026-10-31]
CAD files/Bearing 4Bore 13Ext 5.SLDPRT
13.0 x 5.00 x 13.0 mm
