wuyang20061105-oss/roboarm-_yang/CAD files/4M2CB.SLDPRT

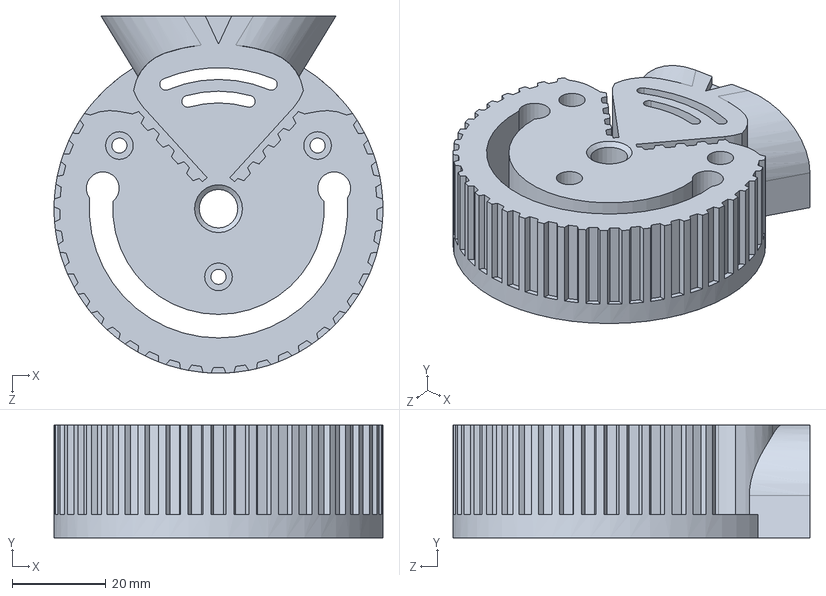
[picture p59: CAD file, 2026-10-31]
CAD files/4M2CB.SLDPRT
70.0 x 24.0 x 76.0 mm
