wuyang20061105-oss/roboarm-_yang/CAD files/Capacitor 1.SLDPRT

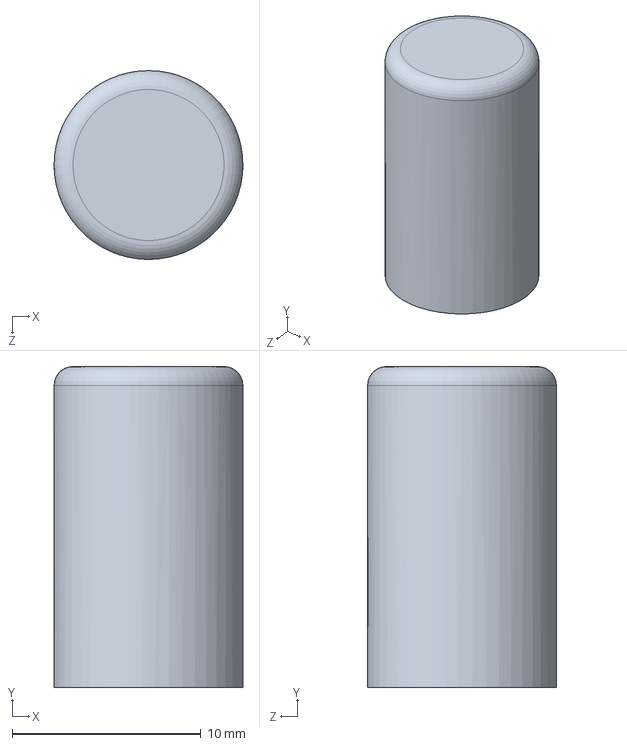
[picture p60: CAD file, 2026-10-31]
CAD files/Capacitor 1.SLDPRT
10.0 x 17.0 x 10.0 mm
