wuyang20061105-oss/roboarm-_yang/CAD files/Capacitor 2.SLDPRT

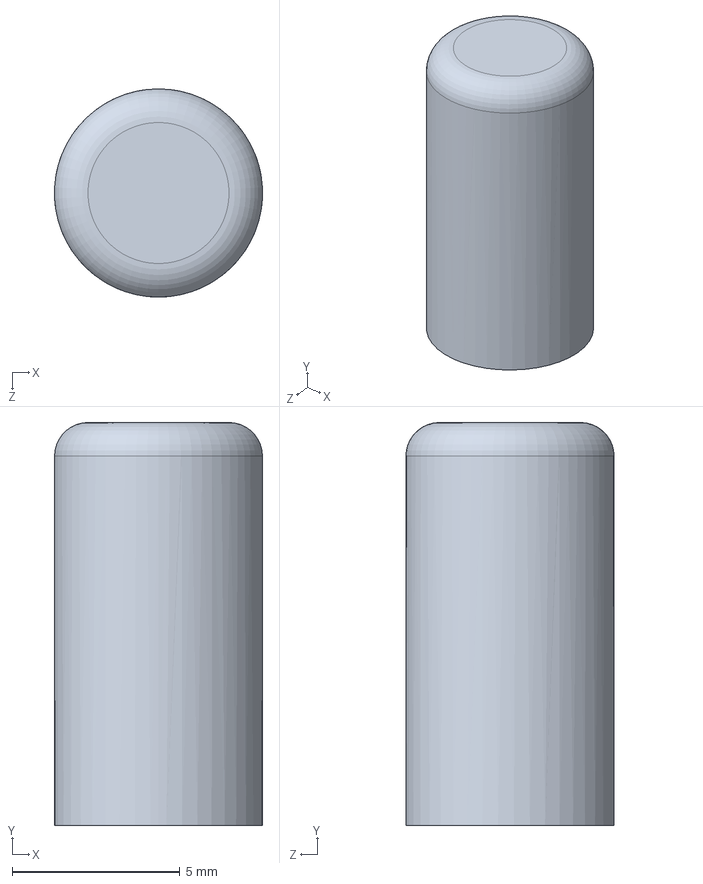
[picture p61: CAD file, 2026-10-31]
CAD files/Capacitor 2.SLDPRT
6.20 x 12.0 x 6.20 mm
