wuyang20061105-oss/roboarm-_yang/CAD files/Brass insert M4.SLDPRT

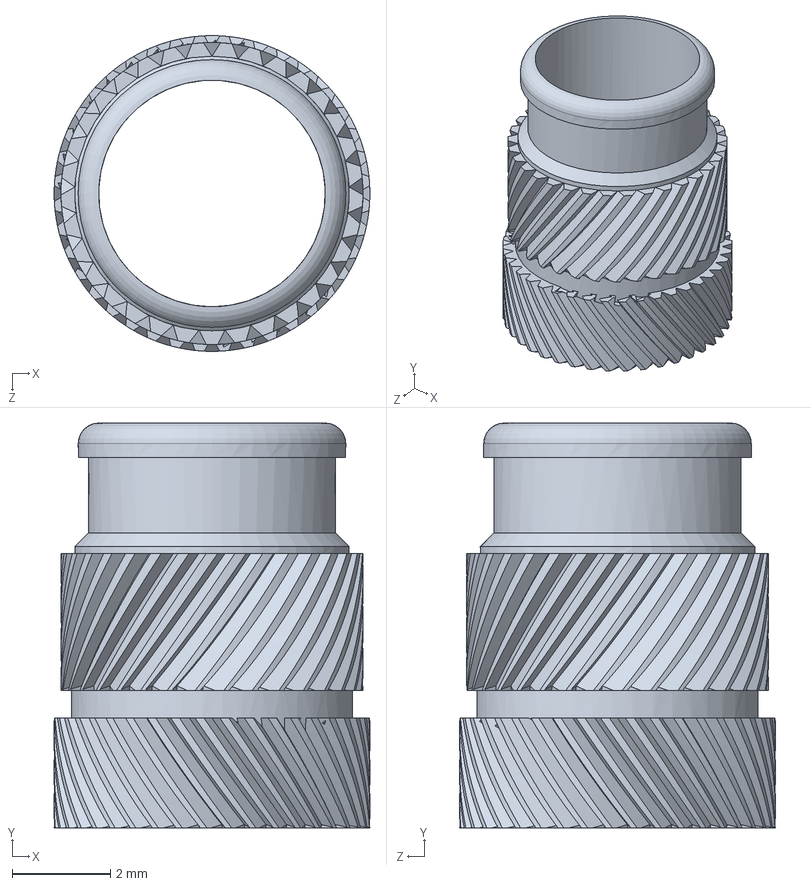
[picture p62: CAD file, 2026-10-31]
CAD files/Brass insert M4.SLDPRT
6.44 x 8.26 x 6.44 mm
