wuyang20061105-oss/roboarm-_yang/CAD files/Bearing 3Bore 10Ext 4Height.SLDPRT

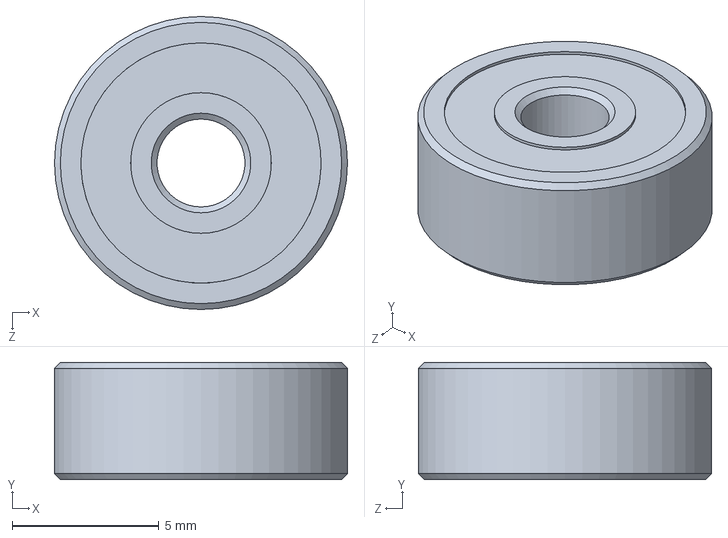
[picture p63: CAD file, 2026-10-31]
CAD files/Bearing 3Bore 10Ext 4Height.SLDPRT
10.0 x 4.00 x 10.0 mm
