wuyang20061105-oss/roboarm-_yang/CAD files/Coupling 5 to 8 mm.SLDPRT

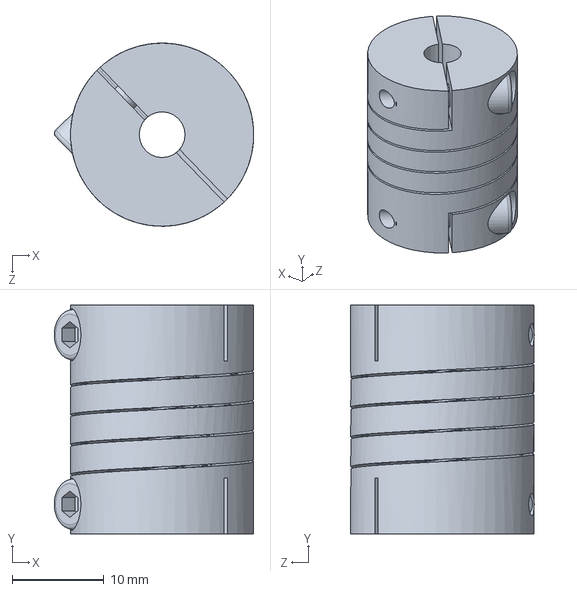
[picture p64: CAD file, 2026-10-31]
CAD files/Coupling 5 to 8 mm.SLDPRT
21.8 x 25.0 x 20.0 mm
