wuyang20061105-oss/roboarm-_yang/CAD files/1M3A.SLDPRT

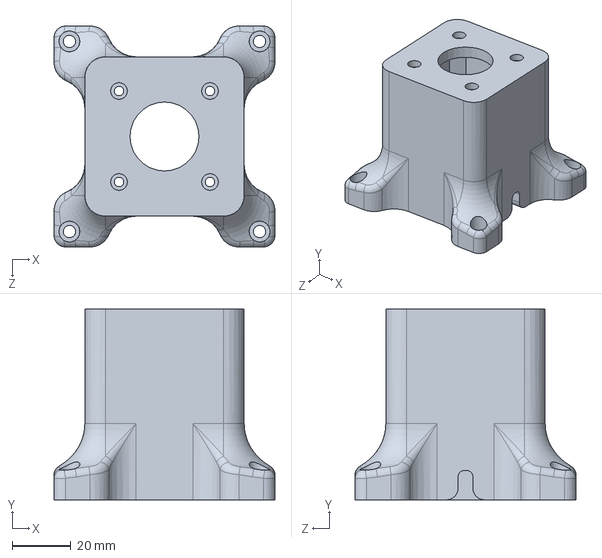
[picture p65: CAD file, 2026-10-31]
CAD files/1M3A.SLDPRT
75.3 x 65.0 x 75.3 mm
