wuyang20061105-oss/roboarm-_yang/CAD files/Chip.SLDPRT

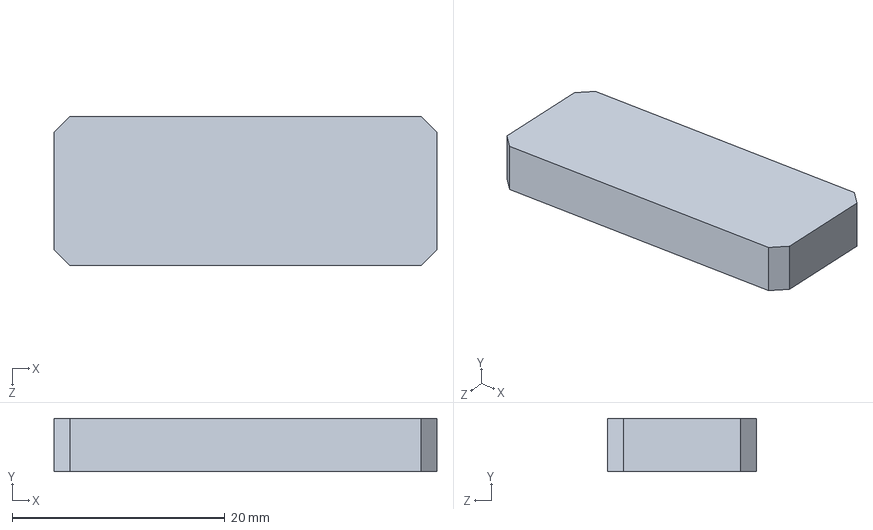
[picture p66: CAD file, 2026-10-31]
CAD files/Chip.SLDPRT
36.0 x 5.00 x 14.0 mm
