wuyang20061105-oss/roboarm-_yang/CAD files/Base fusta.SLDPRT

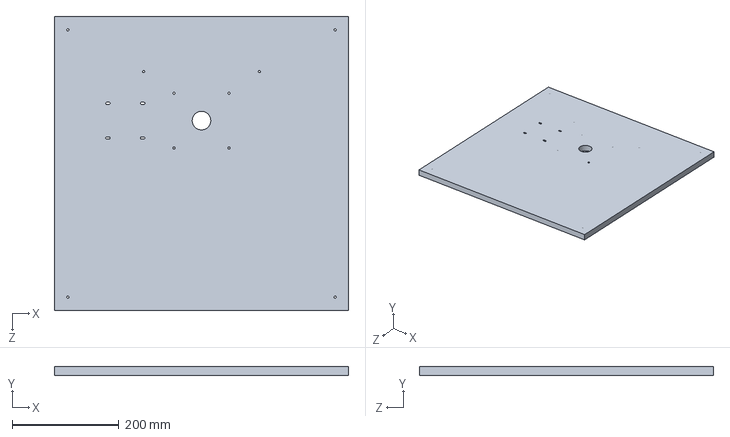
[picture p67: CAD file, 2026-10-31]
CAD files/Base fusta.SLDPRT
550.0 x 16.0 x 550.0 mm
