wuyang20061105-oss/roboarm-_yang/CAD files/3M2CC.SLDPRT

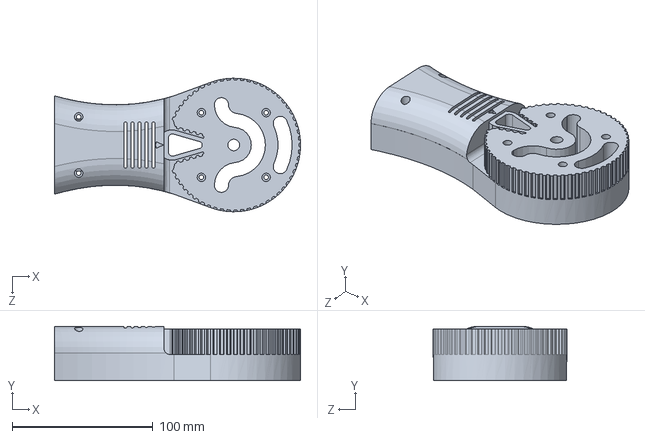
[picture p68: CAD file, 2026-10-31]
CAD files/3M2CC.SLDPRT
175.0 x 38.8 x 95.0 mm
