wuyang20061105-oss/roboarm-_yang/CAD files/3M1D.SLDPRT

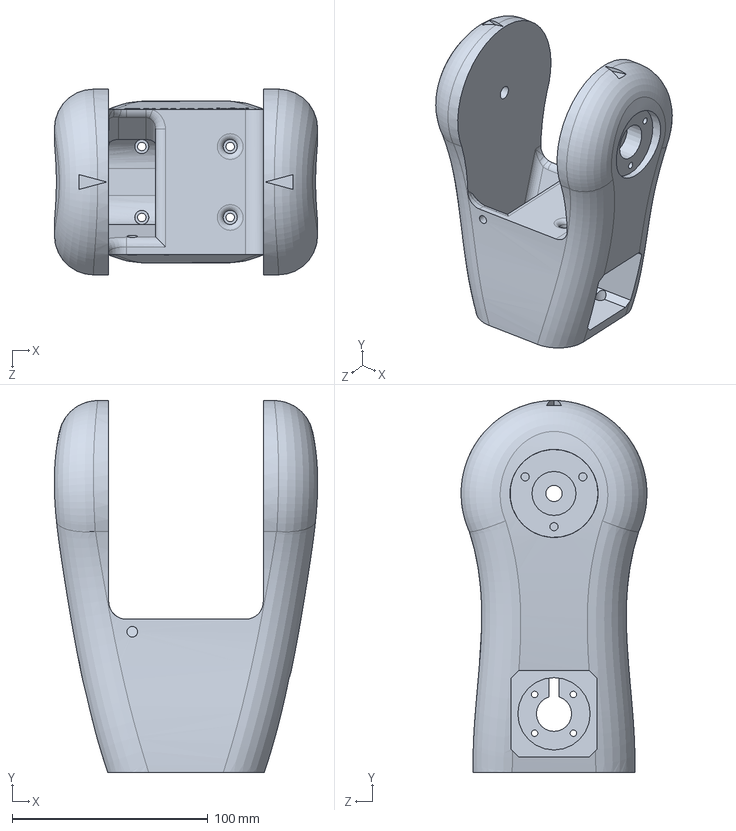
[picture p69: CAD file, 2026-10-31]
CAD files/3M1D.SLDPRT
134.6 x 190.1 x 95.0 mm
