wuyang20061105-oss/roboarm-_yang/CAD files/3M2C.SLDPRT

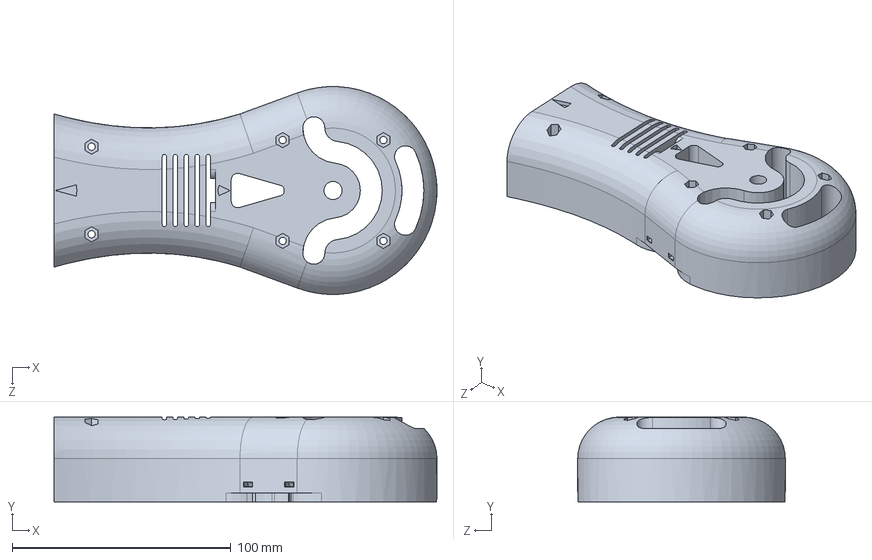
[picture p70: CAD file, 2026-10-31]
CAD files/3M2C.SLDPRT
175.0 x 38.8 x 94.9 mm
