wuyang20061105-oss/roboarm-_yang/CAD files/Bottom Plate C.SLDPRT

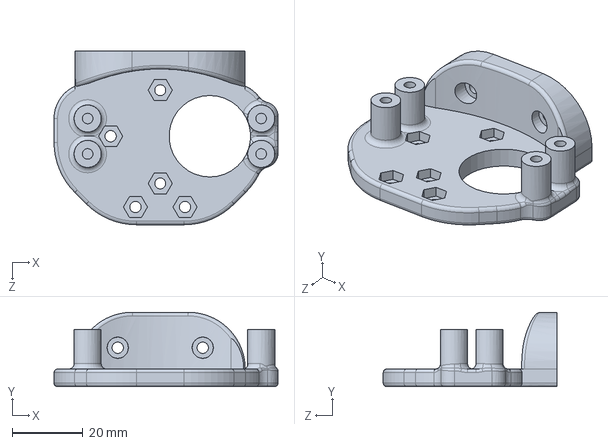
[picture p71: CAD file, 2026-10-31]
CAD files/Bottom Plate C.SLDPRT
63.2 x 21.0 x 49.0 mm
