wuyang20061105-oss/roboarm-_yang/CAD files/Barra llisa 8mm x 80mm.SLDPRT

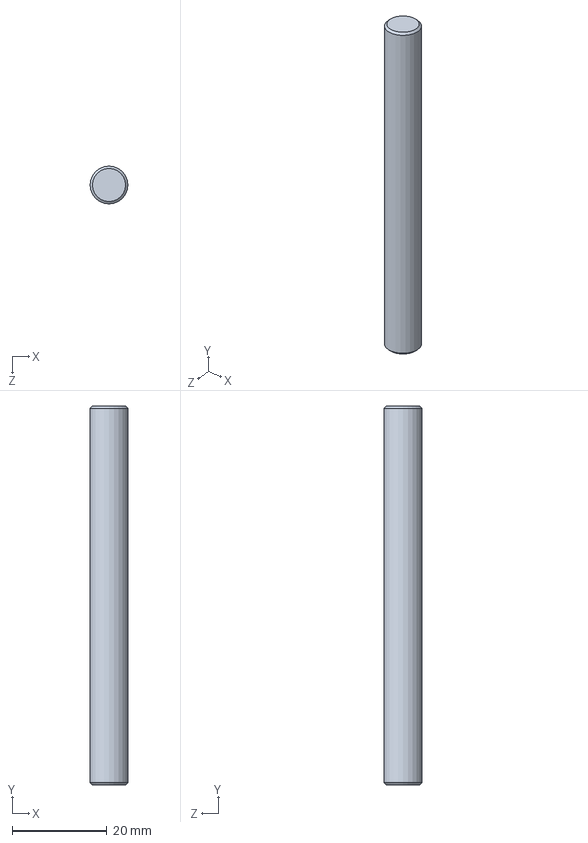
[picture p72: CAD file, 2026-10-31]
CAD files/Barra llisa 8mm x 80mm.SLDPRT
8.00 x 80.0 x 8.00 mm
