wuyang20061105-oss/roboarm-_yang/CAD files/Brass insert M3.SLDPRT

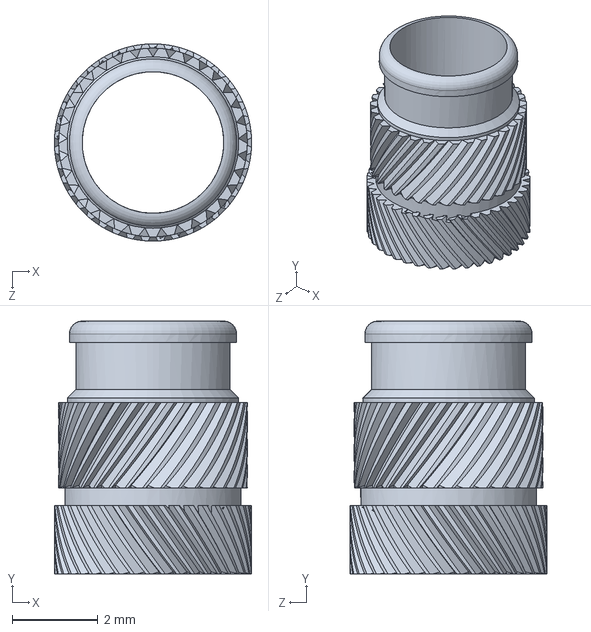
[picture p73: CAD file, 2026-10-31]
CAD files/Brass insert M3.SLDPRT
4.60 x 5.90 x 4.60 mm
