wuyang20061105-oss/roboarm-_yang/(list of files, cad)

Other CAD files:
CAD files/2M2 assembly.SLDASM
STL files/Articulation 1/1M2.STL
STL files/Articulation 2/2M2H.STL
STL files/Machine - tool/Gripper Right.STL
CAD files/4M2B.SLDPRT
RA_P300_Precision.dwg
CAD files/Idol Gear B.SLDPRT
CAD files/Gripper Right B.SLDPRT
CAD files/Box C.SLDPRT
CAD files/Gripper Left B.SLDPRT
CAD files/Fan Module.SLDPRT
CAD files/2M2MA.SLDPRT
CAD files/2M2HA.SLDPRT
CAD files/Cilinder.SLDPRT
CAD files/2M1D.SLDPRT
CAD files/M3 Nut.SLDPRT
CAD files/M3x10.SLDPRT
CAD files/M3x12.SLDPRT
